joaobritooo/tobri-synth-rp2040/docs/img/overview.png

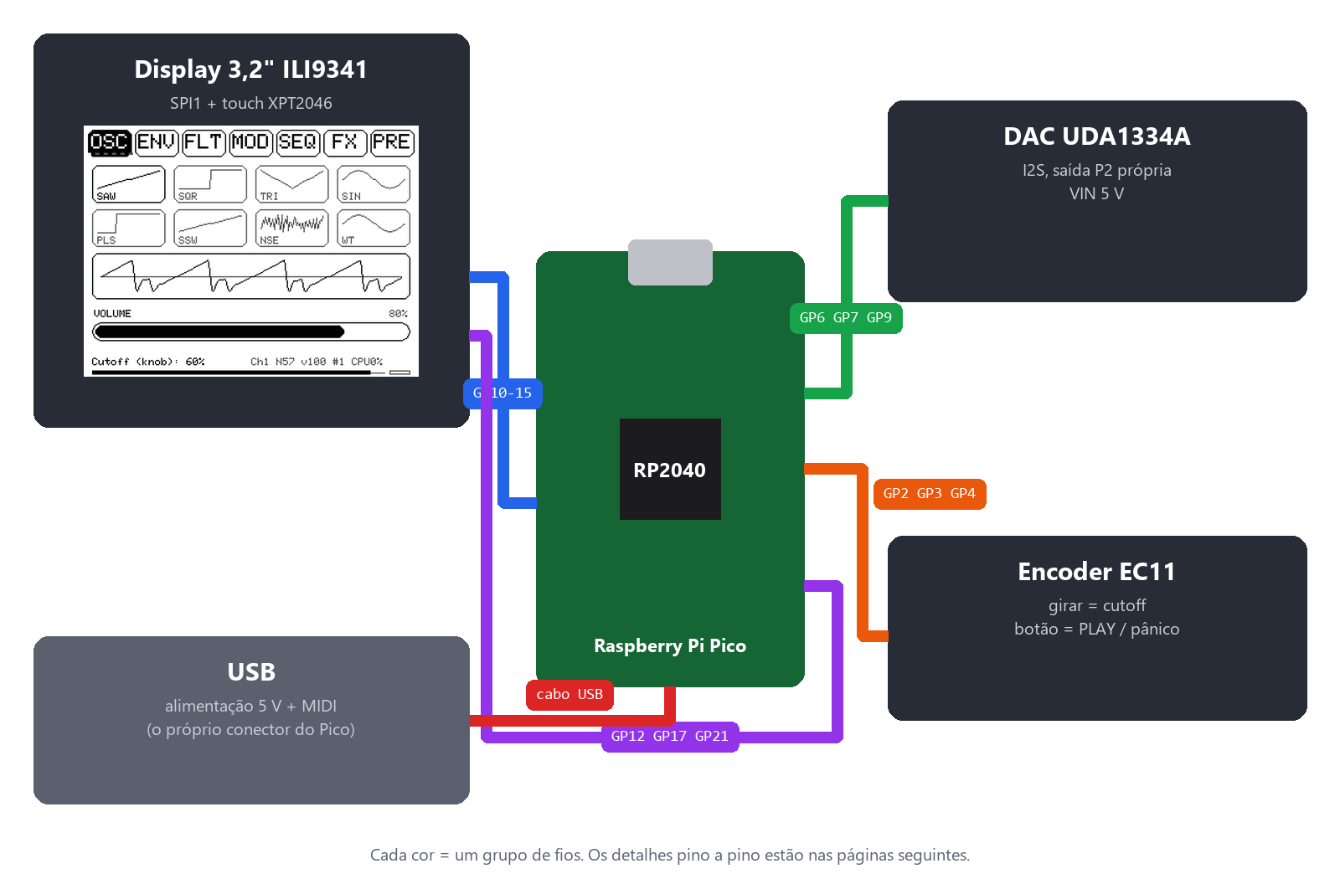
docs/img/overview.png
