joaobritooo/tobri-synth-rp2040/docs/img/screen_env.png

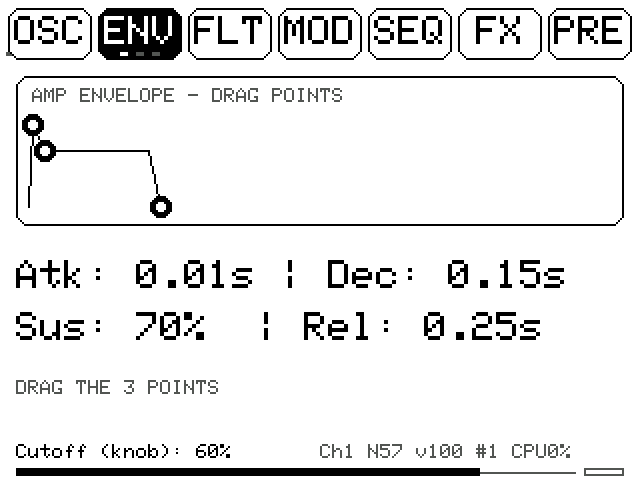
docs/img/screen_env.png
