joaobritooo/tobri-synth-rp2040/docs/img/screen_fx1.png

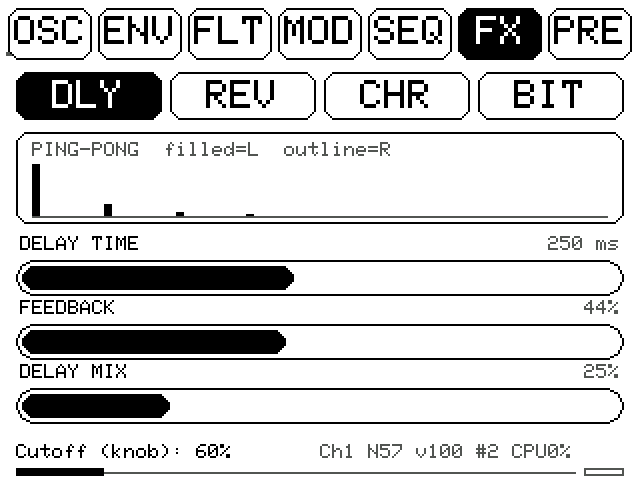
docs/img/screen_fx1.png
