joaobritooo/tobri-synth-rp2040/docs/img/screen_osc6.png

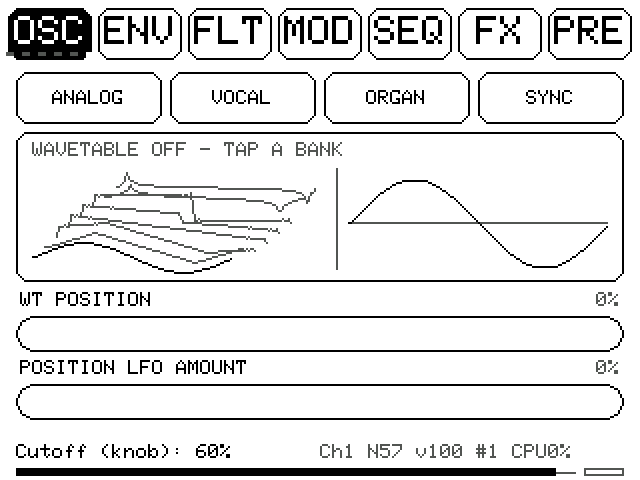
docs/img/screen_osc6.png
