joaobritooo/tobri-synth-rp2040/docs/img/screen_pre1.png

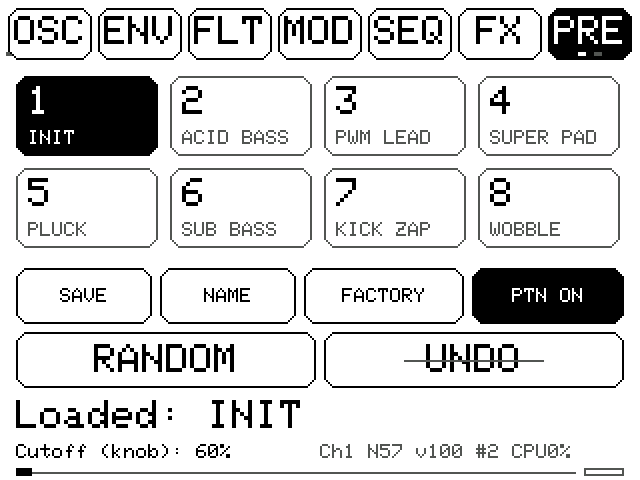
docs/img/screen_pre1.png
