joaobritooo/tobri-synth-rp2040/case/stl/tobri_panel.stl

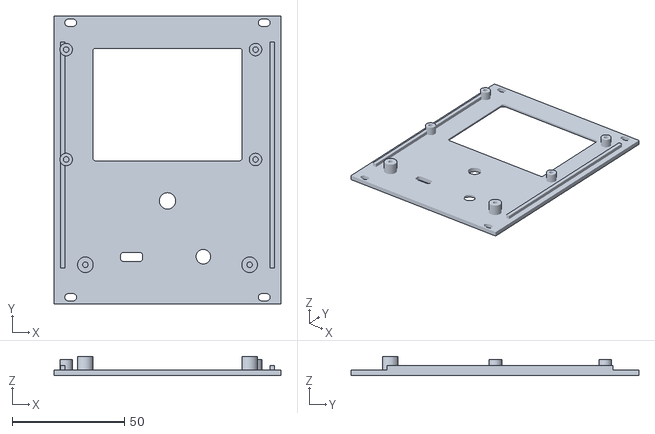
[picture p20: CAD file, 2026-10-31]
case/stl/tobri_panel.stl
101.3 x 128.5 x 8.50
