joaobritooo/tobri-synth-rp2040/case/stl/tobri_shelf.stl

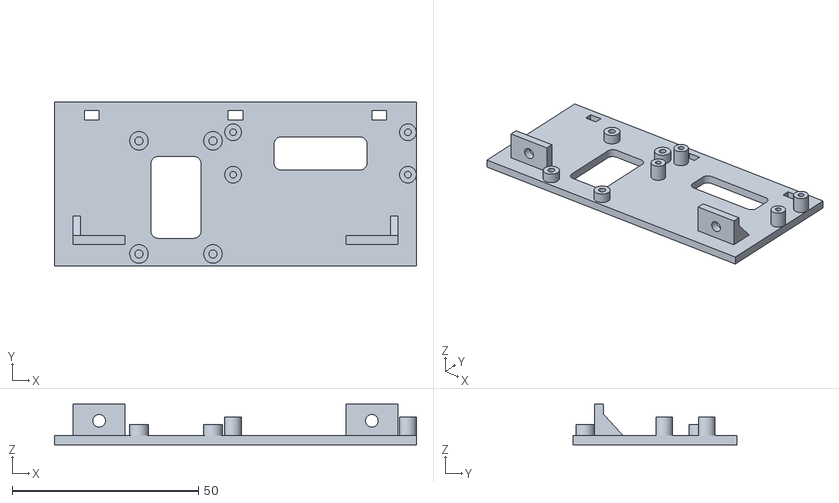
[picture p21: CAD file, 2026-10-31]
case/stl/tobri_shelf.stl
97.3 x 44.0 x 11.0
