joaobritooo/tobri-synth-rp2040/case/stl/tobri_knob.stl

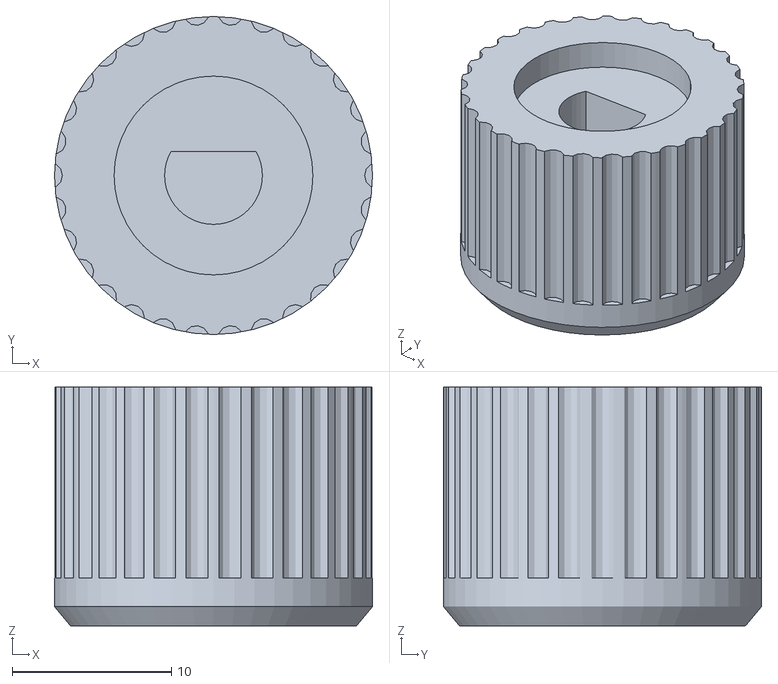
[picture p22: CAD file, 2026-10-31]
case/stl/tobri_knob.stl
20.0 x 20.0 x 15.0
