joaobritooo/tobri-synth-rp2040/(list of files, cad)

Other CAD files:
case/tobri_painel_knob.scad
