joaobritooo/tobri-synth-rp2040/firmware/tobri_synth_firmware_touchscreen_5/tobri_synth_firmware_touchscreen_5.ino

/* ============================================================================
   SINTETIZADOR RP2040 — USB MIDI DEVICE + TELA TOUCH (Tobri Synth)
   Abas: OSC / ENV / FLT / MOD / SEQ / FX / PRE
   (toque de novo na aba ativa para alternar entre as páginas)
   FX: DLY / REV / CHR / BIT   |   PRE página 2: MIDI MAP (learn dos knobs)
   NOVO: FLT p2 = filtro 12/24 dB | SEQ p3 = padrões A-D + chain |
         SEQ p1 = PROB e RATCH por passo | MOD p4 = matriz de modulação 4x4
   v5 (toque): leitura filtrada com máquina de estados (pollTouch), slider
         "preso" ao dedo durante o arraste, redesenho só quando o valor muda,
         FINE (afaste o dedo da barra na vertical), calibração do touch na EEPROM
         (PRE p2 > TOUCH CAL, ou segure o dedo na tela ao ligar)
   WAVETABLE: onda "WT" (OSC p1) + OSC p6 = 4 bancos x 8 quadros com morph;
         posição modulada pelo LFO e pela linha PWM/WT da matriz (MOD p4)
   v6: LFO com 5 formas + SYNC ao BPM (MOD p1) | accent 303 (SEQ p2) | ring mod
         (OSC p4) | wavefolder (FLT p2) | swipe troca subpágina | toque duplo no
         slider = valor padrão | UNDO depois de RND/CLR/COPY | medidor de saída
   v7: toque na aba ativa abre o MENU das subpáginas (com nomes). ENV agora tem
         AMP / FILTER ENV / PITCH ENV; FLT = FILTER (cutoff, reso, drive) + MODE
         (tipo, inclinação, wavefolder); MOD = LFO / MATRIX / VOICES
   v12: encoder com giro em GP4/GP3 e botão em GP2 (como está ligado na placa)
   v11: presets de fábrica minimal / deep tech (ROLLER, DUB CHORD, HYPNO PLCK, RUMBLE,
         BLIP, DEEP PAD, ACID TOOL, METAL PERC), cada um com groove próprio em Sol menor
   v10: botão do encoder ignora "apertos" que acontecem enquanto o eixo gira (ruído do
         SW); teste do encoder ao vivo em MOD > VOICE/GLIDE
   v9: abertura com as cores do menu + transição (varredura e abas caindo)
   v8: PRE p1 > RANDOM sorteia um som com "cara" (BASS, LEAD, PAD, PLUCK, KEYS) dentro de
         faixas musicais; UNDO volta ao som anterior (e REDO refaz) | tela de abertura
         com números caindo estilo Matrix
   ENCODER: girar = CUTOFF, segurar+girar = RESSONÂNCIA, clique = PLAY/STOP do
         SEQ, segurar parado = PÂNICO (lido por interrupção, com aceleração)
   Áudio 100% em inteiros (sem float por amostra); os floats são convertidos
   pelo core da tela em publishParams().
   ============================================================================ */

#ifndef USE_TINYUSB
#error "Arduino IDE: Ferramentas > USB Stack > selecione 'Adafruit TinyUSB' (o USB MIDI precisa dele)"
#endif
#include "Adafruit_TinyUSB.h"
#include <MIDI.h>
#include <I2S.h>
#include <SPI.h>
#include <EEPROM.h>
#include <Adafruit_GFX.h>
#include <Adafruit_ILI9341.h>
#include <XPT2046_Touchscreen.h>
#include <math.h>
#include <stdarg.h>

Adafruit_USBD_MIDI usb_midi;
MIDI_CREATE_INSTANCE(Adafruit_USBD_MIDI, usb_midi, MIDI);

// ---------------- PINOS ----------------
const int I2S_BCLK_PIN = 6;
const int I2S_DATA_PIN = 9;
I2S i2s(OUTPUT);

// encoder: giro em GP4 (CLK/A) e GP3 (DT/B), botão em GP2 (igual à montagem do protótipo)
const int ENC_CLK = 4, ENC_DT = 3, ENC_SW = 2;

const int TFT_SCK = 10, TFT_MOSI = 11, TFT_CS = 13, TFT_DC = 14, TFT_RST = 15;
Adafruit_ILI9341 tft = Adafruit_ILI9341(&SPI1, TFT_DC, TFT_CS, TFT_RST);

const int TOUCH_CS = 17, TOUCH_IRQ = 21, TOUCH_MISO = 12;
XPT2046_Touchscreen ts(TOUCH_CS, TOUCH_IRQ);

#define TS_MINX 315
#define TS_MAXX 3826
#define TS_MINY 310
#define TS_MAXY 3790

static bool core1_booting = true;

// ---------------- PALETA (Tema Limpo / Alto Contraste) ----------------
#define COL_BG      0xFFFF // Fundo Branco
#define COL_BORDER  0x0000 // Bordas e textos Pretos
#define COL_ACCENT  0x0000 // Elementos ativos Pretos
#define COL_ACCENT2 0x0000 // Linhas Pretas
#define COL_WARN    0x0000 // Avisos Pretos
#define COL_TEXT    0x0000 // Texto geral Preto
#define COL_MUTED   0x52AA // Cinza secundário
const int RADIUS = 6;

// ---------------- CANVAS (buffers anti-flicker) ----------------
const int PANEL_W = 304;
const int PANEL_H_MAX = 75;
GFXcanvas16 panelCanvas(PANEL_W, PANEL_H_MAX);
GFXcanvas16 sliderCanvas(PANEL_W, 30);

// ---------------- CONFIG DE AUDIO ----------------
const uint32_t SAMPLE_RATE   = 32000;
const int      MAX_VOICES     = 4;
const int      WAVETABLE_SIZE = 256;
const int32_t  ENV_ONE        = 1 << 24;     // envelopes em ponto fixo Q24
int16_t sineTable[WAVETABLE_SIZE];

enum Waveform  { WAVE_SAW = 0, WAVE_SQUARE, WAVE_TRIANGLE, WAVE_SINE, WAVE_PULSE, WAVE_SUPERSAW, WAVE_NOISE, WAVE_TABLE, WAVE_COUNT };
enum EnvStage  { ENV_IDLE = 0, ENV_ATTACK, ENV_DECAY, ENV_SUSTAIN, ENV_RELEASE };
enum Page      { PAGE_OSC = 0, PAGE_ENV = 1, PAGE_FLT = 2, PAGE_MOD = 3, PAGE_SEQ = 4, PAGE_FX = 5, PAGE_PRE = 6 };

struct Voice {
    bool    active = false;
    uint8_t note = 0;
    uint8_t velocity = 0;
    int32_t gainQ15 = 0;
    uint32_t phase = 0, phase2 = 0, phase3 = 0, phaseSub = 0;
    uint32_t phaseO2 = 0;              // OSC2: fase
    uint32_t uph[5] = {0, 0, 0, 0, 0}; // unison: fase de cada cópia
    uint32_t phaseFm = 0, pmOff = 0;   // FM: fase do modulador e desvio aplicado à portadora
    int32_t  fmEnv = 0, fmPrev = 0;    // FM: envelope do índice (Q24) e última saída do modulador (feedback)
    uint32_t phaseInc = 0;
    uint32_t incEff = 0;
    uint32_t inc2 = 0, inc3 = 0;
    uint32_t targetInc = 0;
    int32_t env = 0;
    EnvStage stage = ENV_IDLE;
    int32_t filtEnv = 0;
    EnvStage filtStage = ENV_IDLE;
    int32_t pitchEnv = 0;
    uint32_t age = 0;
};
Voice voices[MAX_VOICES];
uint32_t voiceCounter = 0;

Waveform currentWave  = WAVE_SAW;
float paramAttack  = 0.01f, paramDecay = 0.15f, paramSustain = 0.70f, paramRelease = 0.25f;
float paramCutoff  = 0.60f, paramReso = 0.20f, paramVolume = 0.80f;

float paramFiltAtt   = 0.01f;
float paramFiltDec   = 0.20f;
float paramFiltAmt   = 0.50f;

float paramLfoRate  = 2.0f;
float paramLfoDepth = 0.0f;
float paramDetune   = 0.50f;

float paramPwm        = 0.30f;
float paramPwmMod     = 0.00f;
float paramSubLevel   = 0.00f;
float paramPitchAmt   = 0.00f;
float paramPitchDecMs = 80.0f;
float paramVelFilt    = 0.00f;
float paramSwing      = 0.00f;
float paramDrive      = 0.00f;
float paramGlideMs    = 60.0f;

// FM (modulação de fase por 1 operador modulador, seno)
float paramFmAmt     = 0.00f;    // quantidade (índice máx. ~12,6 rad, curva quadrática)
float paramFmRatio   = 2.00f;    // razão modulador/portadora
float paramFmDecMs   = 200.0f;   // decaimento do envelope do índice
float paramFmEnv     = 0.50f;    // quanto o índice segue o envelope (0 = constante)
float paramFmFb      = 0.00f;    // feedback do modulador (deixa o timbre mais "serrilhado")
static volatile bool fmSnap = true;   // razão em passos de 0,5

// OSC2 (segundo oscilador, com hard sync) e UNISON
float paramO2Lvl  = 0.00f;     // nível (0 = desligado)
float paramO2Semi = 0.0f;      // -24..+24 semitons
float paramO2Det  = 0.0f;      // -100..+100 cents
float paramUniDet = 0.40f;     // abertura do unison
static volatile uint8_t o2Wave = 0;     // 0 saw, 1 quadrada, 2 triangular, 3 senoide
static volatile bool    o2Sync = false;
static volatile uint8_t uniSel = 0;     // 0 = off, 1 = 2 cópias, 2 = 3 cópias, 3 = 5 cópias
static volatile uint8_t subMode = 0;        // 0 = quadrada, 1 = senoide
static volatile uint8_t filtMode = 0;       // 0 = LP, 1 = BP, 2 = HP
static volatile uint8_t filtSlope = 0;      // 0 = 12 dB/oit, 1 = 24 dB/oit (2 SVF em cascata)
static volatile uint8_t voiceMode = 0;      // 0 = POLY, 1 = MONO, 2 = LEGATO
static volatile bool    monoResetReq = false;
static volatile uint8_t lastVelocity = 100;
static volatile uint8_t cpuPct = 0;

// Efeitos
float paramDelayTime = 250.0f;
float paramDelayFb   = 0.40f;
float paramDelayMix  = 0.25f;
float paramRevSize   = 0.60f;
float paramRevDamp   = 0.40f;
float paramRevMix    = 0.20f;
float paramChoRate   = 0.80f;
float paramChoDepth  = 0.50f;
float paramChoMix    = 0.00f;
float paramCrBits    = 16.0f;
float paramCrRate    = 1.0f;
float paramCrMix     = 0.00f;

// LFO: forma e sincronia com o BPM | accent 303 | ring mod | wavefolder
static volatile uint8_t lfoShape = 0;      // 0 seno, 1 triângulo, 2 dente de serra, 3 quadrada, 4 sample & hold
static volatile bool    lfoSync  = false;  // true: o LFO RATE vira divisão do BPM do sequenciador
float paramAccent = 0.40f;                 // accent 303: quanto cada passo com accent abre o filtro (acumula)
static volatile bool    o2Ring = false;    // OSC2 vira ring mod (OSC1 x OSC2)
float paramFold   = 0.00f;                 // wavefolder antes do filtro
static volatile int32_t pAccentQ15 = 13107, pFoldGainQ8 = 256;
static volatile bool    pFoldOn = false;
static volatile int32_t outPeak = 0;       // pico da saída (medidor na barra de baixo)
static volatile bool    outClip = false;

// divisões do LFO sincronizado (em notas inteiras: 1 = um compasso 4/4)
const float LFO_SYNC_WHOLE[9] = {2.0f, 1.0f, 0.5f, 0.25f, 1.0f / 6.0f, 0.125f, 1.0f / 12.0f, 0.0625f, 0.03125f};
const char* LFO_SYNC_NAMES[9] = {"2 BARS", "1 BAR", "1/2", "1/4", "1/4T", "1/8", "1/8T", "1/16", "1/32"};

// Estado do filtro (ponto fixo Q8) e do LFO (fase de 32 bits)
static int32_t  svL = 0, svB = 0;
static int32_t  sv2L = 0, sv2B = 0;            // 2º estágio do filtro (modo 24 dB)
static int32_t  volTargetQ15 = 26214, volCurQ15 = 26214;
static uint32_t pitchModMul = 65536;           // multiplicador de pitch da matriz (Q16)
static uint32_t pitchModTbl[129];              // 2^((i-64)/64) em Q16 (±1 oitava)

// Matriz de modulação: índice = destino*4 + fonte
// fontes: 0 LFO, 1 FILT ENV, 2 AMP ENV, 3 VELOCITY | destinos: 0 CUTOFF, 1 PITCH, 2 PWM, 3 VOLUME
float mmAmt[16] = {0};
static volatile int32_t pMmQ15[16];
static volatile bool    pMmOn = false, pPitchModOn = false;
static uint32_t lfoPhase32 = 0;
static int32_t  lfoHold = 0;                   // valor segurado do LFO sample & hold
static int32_t  accentEnvQ15 = 0;              // carga do accent 303 (core de áudio)
int16_t lastPlayedSample = 0;

// ---- Parâmetros PUBLICADOS em ponto fixo ----
// O core da tela (publishParams) converte os floats; o core de áudio só lê inteiros.
static volatile int32_t  pCutBaseQ15 = 19661, pLfoHalfQ15 = 0, pFiltAmtQ15 = 16384, pVelFiltQ15 = 0;
static volatile int32_t  pQTargetQ14 = 12000;
static volatile uint32_t pLfoInc32 = 268435;
static volatile int32_t  pPwmBaseQ16 = 19661, pPwmModQ16 = 0;
static volatile bool     pDriveOn = false;
static volatile int32_t  pDriveGainQ8 = 256, pDriveCompQ15 = 32768;
static volatile int32_t  pSelfWetQ15 = 0;
static volatile bool     pSeedOn = false;
static volatile int32_t  pSpreadQ16 = 0;
static volatile int32_t  pMainGainQ15 = 32768, pSubGainQ15 = 0;
static volatile int32_t  pSwingQ8 = 0;
static volatile int      pGlideShift = 11;
static volatile int32_t  pPitchDecInc = 1;
static volatile bool     pPitchOn = false;
static volatile bool     pFmOn = false;
static volatile bool     pO2On = false, pO2Sync = false;
static volatile int32_t  pO2MulQ8 = 256, pO2MainQ15 = 32768, pO2GainQ15 = 0;
static volatile int      pUniN = 1;
static volatile int32_t  pUniGainQ15 = 32768;
static volatile int32_t  pUniSpreadQ16[5] = {0, 0, 0, 0, 0};
static volatile int32_t  pFmIdxQ12 = 0, pFmRatioQ8 = 512, pFmEnvQ15 = 16384, pFmFbQ12 = 0, pFmDecInc = 1;

// Osciloscópio
const int SCOPE_LEN = 512;
static int16_t scopeBuf[SCOPE_LEN];
static volatile uint16_t scopeW = 0;

// ---------------- WIDGETS / ESTRUTURAS ----------------
// fmt: 0 = %, 1 = Hz, 2 = ms, 3 = semitons, 4 = segundos em ms, 5 = bits, 6 = divisor 1/n
struct TouchSlider { int x, y, w, h; float *value; float minV, maxV; const char *label; uint8_t fmt; float last; float def; };   // def: preenchido no boot
struct Btn         { int x, y, w, h; const char *label; };
// probIdx: 0=100% 1=75% 2=50% 3=25%  |  ratchIdx: 0..3 = 1x..4x (zero = padrão)
struct SeqStep     { uint8_t semi; int8_t oct; bool gate; bool accent; bool slide; uint8_t probIdx; uint8_t ratchIdx; };
struct AdsrPts     { int xa, xd, xs, xr, yTop, ySus, yBot; };

// Preset gravado na flash (160 bytes)
struct PresetData {
    uint8_t  magic, wave, hasPattern, reserved;
    uint16_t bpm, crc;
    float attack, decay, sustain, release;
    float cutoff, reso, filtAmt, filtAtt, filtDec;
    float lfoRate, lfoDepth, detune, volume;
    float dlyTime, dlyFb, dlyMix, revSize, revDamp, revMix;
    float pwm, pwmMod, subLevel, pitchAmt, pitchDec, velFilt, swing;
    uint8_t semi[16];
    int8_t  oct[16];
    uint8_t flags[16];
};

// cópia do som para o UNDO/REDO do RANDOM (PRE p1)
struct SoundSnap { float f[48]; uint8_t b[12]; float mm[16]; uint8_t wave; };
uint8_t rndUndoState = 0;            // 0 = nada para desfazer, 1 = UNDO disponível, 2 = REDO disponível

// Preset de fábrica
struct FactoryPreset {
    const char *name; uint8_t wave;
    float a, d, s, r;
    float cut, res, fAmt, fAtt, fDec;
    float lfoR, lfoD, det, vol;
    float dT, dF, dM;
    float rS, rD, rM;
    float pwm, pwmMod, sub, pAmt, pDecMs, vel;
    float drive; uint8_t fmode; uint8_t vmode; float glide;
};

const int PRESET_COUNT = 8;
volatile int presetReq = -1;
bool presetLoadPattern = true;
int  presetCur = 0;
bool slotIsUser[PRESET_COUNT] = {false, false, false, false, false, false, false, false};
char presetMsg[40] = "Tap a slot to load";

// Aba OSC
TouchSlider sliderVolume   = {8, 176, 304, 30, &paramVolume,   0.0f, 1.0f,  "VOLUME",      0, -999.0f};
TouchSlider sliderPwm      = {8, 118, 304, 30, &paramPwm,      0.05f, 0.95f, "PULSE WIDTH", 0, -999.0f};
TouchSlider sliderPwmMod   = {8, 150, 304, 30, &paramPwmMod,   0.0f, 1.0f,  "PWM LFO AMOUNT", 0, -999.0f};
TouchSlider sliderSubLvl   = {8, 182, 304, 30, &paramSubLevel, 0.0f, 1.0f,  "SUB LEVEL",   0, -999.0f};
// Aba FLT
TouchSlider sliderCutoff   = {8, 118, 304, 30, &paramCutoff,   0.05f, 1.0f, "CUTOFF FREQ", 0, -999.0f};
TouchSlider sliderReso     = {8, 150, 304, 30, &paramReso,     0.0f, 1.0f,  "RESSONANCIA", 0, -999.0f};
TouchSlider sliderFiltAmt  = {8, 96,  304, 30, &paramFiltAmt,  0.0f, 1.0f,  "FILTER ENV AMOUNT", 0, -999.0f};
TouchSlider sliderDrive    = {8, 182, 304, 30, &paramDrive,    0.0f, 1.0f,  "DRIVE",       0, -999.0f};
TouchSlider sliderFAtt     = {8, 128, 304, 30, &paramFiltAtt,  0.001f, 1.0f, "FILTER ENV ATTACK", 4, -999.0f};
TouchSlider sliderFDec     = {8, 160, 304, 30, &paramFiltDec,  0.01f, 2.0f, "FILTER ENV DECAY",  4, -999.0f};
TouchSlider sliderFold     = {8, 100, 304, 30, &paramFold,     0.0f, 1.0f,  "WAVEFOLDER",  0, -999.0f};
// Aba MOD
TouchSlider sliderLfoRate  = {8, 118, 304, 30, &paramLfoRate,  0.1f, 20.0f, "LFO RATE",    1, -999.0f};
TouchSlider sliderLfoDepth = {8, 150, 304, 30, &paramLfoDepth, 0.0f, 1.0f,  "LFO DEPTH",   0, -999.0f};
TouchSlider sliderDetune   = {8, 182, 304, 30, &paramDetune,   0.0f, 1.0f,  "DETUNE",      0, -999.0f};
TouchSlider sliderPitchAmt = {8, 118, 304, 30, &paramPitchAmt, 0.0f, 1.0f,  "PITCH ENV AMOUNT", 3, -999.0f};
TouchSlider sliderPitchDec = {8, 150, 304, 30, &paramPitchDecMs, 5.0f, 800.0f, "PITCH ENV DECAY", 2, -999.0f};
TouchSlider sliderVelFilt  = {8, 192, 304, 28, &paramVelFilt,  0.0f, 1.0f,  "VELOCITY > FILTER", 0, -999.0f};
TouchSlider sliderGlide    = {8, 72,  304, 30, &paramGlideMs,  1.0f, 500.0f, "GLIDE TIME",  2, -999.0f};
// Aba MOD página 4 (matriz): o ponteiro/label mudam conforme a célula selecionada
char mmLabel[24] = "LFO > CUTOFF";
TouchSlider sliderMm       = {8, 162, 304, 30, &mmAmt[0], -1.0f, 1.0f, mmLabel, 7, -999.0f};
// Aba OSC página 3 (FM)
TouchSlider sliderFmAmt    = {8, 62,  304, 30, &paramFmAmt,    0.0f, 1.0f,    "FM AMOUNT",      0, -999.0f};
TouchSlider sliderFmRatio  = {8, 94,  304, 30, &paramFmRatio,  0.5f, 12.0f,   "FM RATIO",       8, -999.0f};
TouchSlider sliderFmDec    = {8, 126, 304, 30, &paramFmDecMs,  5.0f, 2000.0f, "FM DECAY",       2, -999.0f};
TouchSlider sliderFmEnv    = {8, 158, 304, 30, &paramFmEnv,    0.0f, 1.0f,    "FM ENV FOLLOW",  0, -999.0f};
TouchSlider sliderFmFb     = {8, 190, 304, 30, &paramFmFb,     0.0f, 1.0f,    "FM FEEDBACK",    0, -999.0f};
// Aba OSC páginas 4 (OSC2) e 5 (UNISON)
TouchSlider sliderO2Lvl    = {8, 92,  304, 30, &paramO2Lvl,    0.0f, 1.0f,    "OSC2 LEVEL (0 = OFF)", 0, -999.0f};
TouchSlider sliderO2Semi   = {8, 124, 304, 30, &paramO2Semi,   -24.0f, 24.0f, "OSC2 SEMITONES",        9, -999.0f};
TouchSlider sliderO2Det    = {8, 156, 304, 30, &paramO2Det,    -100.0f, 100.0f, "OSC2 FINE TUNE",      10, -999.0f};
TouchSlider sliderUniDet   = {8, 70,  304, 30, &paramUniDet,   0.0f, 1.0f,    "UNISON SPREAD",         0, -999.0f};
// Aba SEQ
TouchSlider sliderSwing    = {8, 70,  304, 30, &paramSwing,    0.0f, 1.0f,  "SWING",       0, -999.0f};
TouchSlider sliderAccent   = {8, 170, 304, 30, &paramAccent,   0.0f, 1.0f,  "ACCENT SWEEP (303)", 0, -999.0f};
// Aba FX
TouchSlider sliderDlyTime  = {8, 118, 304, 30, &paramDelayTime, 40.0f, 500.0f, "DELAY TIME", 2, -999.0f};
TouchSlider sliderDlyFb    = {8, 150, 304, 30, &paramDelayFb,   0.0f, 0.90f,   "FEEDBACK",   0, -999.0f};
TouchSlider sliderDlyMix   = {8, 182, 304, 30, &paramDelayMix,  0.0f, 1.0f,    "DELAY MIX",  0, -999.0f};
TouchSlider sliderRevSize  = {8, 118, 304, 30, &paramRevSize,   0.0f, 1.0f,    "ROOM SIZE",  0, -999.0f};
TouchSlider sliderRevDamp  = {8, 150, 304, 30, &paramRevDamp,   0.0f, 1.0f,    "DAMPING",    0, -999.0f};
TouchSlider sliderRevMix   = {8, 182, 304, 30, &paramRevMix,    0.0f, 1.0f,    "REVERB MIX", 0, -999.0f};
TouchSlider sliderChoRate  = {8, 118, 304, 30, &paramChoRate,   0.1f, 5.0f,    "CHORUS RATE", 1, -999.0f};
TouchSlider sliderChoDepth = {8, 150, 304, 30, &paramChoDepth,  0.0f, 1.0f,    "CHORUS DEPTH", 0, -999.0f};
TouchSlider sliderChoMix   = {8, 182, 304, 30, &paramChoMix,    0.0f, 1.0f,    "CHORUS MIX", 0, -999.0f};
TouchSlider sliderCrBits   = {8, 118, 304, 30, &paramCrBits,    4.0f, 16.0f,   "BIT DEPTH", 5, -999.0f};
TouchSlider sliderCrRate   = {8, 150, 304, 30, &paramCrRate,    1.0f, 24.0f,   "SAMPLE RATE DIVIDER", 6, -999.0f};
TouchSlider sliderCrMix    = {8, 182, 304, 30, &paramCrMix,     0.0f, 1.0f,    "CRUSH MIX",  0, -999.0f};

// índice da divisão do LFO sincronizado (fica depois das structs: o Arduino põe os
// protótipos antes da primeira função do arquivo)
int lfoSyncIdx() { return constrain((int)((paramLfoRate - 0.1f) / 19.9f * 8.0f + 0.5f), 0, 8); }

const uint8_t SYNTH_KEY_LOW  = 24;
const uint8_t SYNTH_KEY_HIGH = 108;
const uint8_t CC_KNOB[8] = {48, 49, 50, 51, 52, 53, 54, 55};
int knobValue[8] = {90, 25, 15, 60, 90, 60, 0, 100};

char lastMidiMsg[40] = "aguardando midi...";
static volatile uint32_t midiRxCount = 0;

// ============================================================================
// OSCILADOR / ENVELOPE / AUDIO  (tudo em inteiros)
// ============================================================================
float noteToFreq(uint8_t note) { return 440.0f * powf(2.0f, (note - 69) / 12.0f); }
uint32_t freqToPhaseInc(float freq) { return (uint32_t)(freq * (4294967296.0 / (double)SAMPLE_RATE)); }

static uint32_t noteIncTable[128];
static uint32_t pitchMulTbl[2][129];            // 2^(oitavas * i/128) em Q16 (duas tabelas, troca atômica)
static volatile uint8_t pitchTblSel = 0;
static uint16_t fTableQ14[1025];                // coeficiente f do filtro (Q14) por posição do cutoff

void initNoteTable() {
    for (int i = 0; i < 128; i++) noteIncTable[i] = freqToPhaseInc(noteToFreq((uint8_t)i));
    for (int t = 0; t < 2; t++) for (int i = 0; i < 129; i++) pitchMulTbl[t][i] = 65536u;
}

// f = 2*sin(pi*fc/fs), fc = 120 + m^2 * 8000 (limitado a 0,45*fs), f <= 1,15
void initFilterTable() {
    for (int i = 0; i <= 1024; i++) {
        float m = (float)i / 1024.0f;
        float fc = 120.0f + m * m * 8000.0f;
        if (fc > (float)SAMPLE_RATE * 0.45f) fc = (float)SAMPLE_RATE * 0.45f;
        float f = 2.0f * sinf((float)M_PI * fc / (float)SAMPLE_RATE);
        if (f > 1.15f) f = 1.15f;
        fTableQ14[i] = (uint16_t)(f * 16384.0f + 0.5f);
    }
}

void initPitchModTable() {
    for (int i = 0; i < 129; i++) pitchModTbl[i] = (uint32_t)(exp2f((float)(i - 64) / 64.0f) * 65536.0f);
}

static uint32_t rngState = 0x1234ABCDu;
static uint32_t pulseWQ32 = 1288490188u;

// ---------------- PolyBLEP em ponto fixo (anti-aliasing) ----------------
static inline __attribute__((always_inline)) int16_t sat16(int32_t v) {
    if (v > 32767)  return 32767;
    if (v < -32768) return -32768;
    return (int16_t)v;
}

static inline __attribute__((always_inline)) uint32_t ratioQ15(uint32_t a, uint32_t b) {
    int s = __builtin_clz(b);
    uint32_t bb = b << s;
    uint32_t aa = a << s;
    return ((aa >> 16) << 15) / (bb >> 16);
}

static int32_t __not_in_flash_func(blepQ15)(uint32_t ph, uint32_t inc) {
    if (inc == 0) return 0;
    if (ph < inc) {
        int32_t x = (int32_t)ratioQ15(ph, inc);
        return 2 * x - ((x * x) >> 15) - 32768;
    }
    uint32_t d = 0u - ph;
    if (d < inc) {
        int32_t y = (int32_t)ratioQ15(d, inc);
        int32_t u = 32768 - y;
        return (u * u) >> 15;
    }
    return 0;
}

// seno com interpolação linear (usado pelo modulador FM e pela onda senoidal)
static inline __attribute__((always_inline)) int32_t sineInterp(uint32_t ph) {
    uint32_t i = ph >> 24;
    int32_t a = sineTable[i], b = sineTable[(i + 1) & 255];
    return a + (((b - a) * (int32_t)((ph >> 16) & 255)) >> 8);
}

// ---------------- WAVETABLE (4 bancos x 8 quadros, morph entre quadros) ----------------
// Quadros gerados por síntese aditiva no boot (wtInit), todos com fase seno: assim o
// crossfade entre quadros vizinhos não cancela harmônicos. Dois níveis de mipmap:
// até 40 harmônicos (sem aliasing até ~400 Hz) e até 10 (para notas mais agudas).
const int      WT_BANKS = 4, WT_FRAMES = 8, WT_LEN = 256;
const int      WT_HARM[2] = {40, 10};
const uint32_t WT_MIP_INC = 53687091u;          // incremento de fase de 400 Hz
const char*    WT_BANK_NAMES[WT_BANKS] = {"ANALOG", "VOCAL", "ORGAN", "SYNC"};
static int16_t wtData[2][WT_BANKS][WT_FRAMES][WT_LEN];   // 32 KB na RAM
static volatile uint8_t wtBank = 0;
float paramWtPos = 0.0f;         // posição base na tabela (0..1)
float paramWtLfo = 0.0f;         // quanto o LFO varre a posição
static volatile int32_t pWtPosQ16 = 0, pWtLfoQ15 = 0;
static int32_t wtPosTarget = 0, wtPosCur = 0;   // Q16: alvo (tick de controle) e suavizado (por amostra)
static int     wtFrame = 0;                     // quadro inferior da interpolação (0..6)
static int32_t wtFracQ14 = 0;

// amplitude do harmônico h (1..40) no quadro f de cada banco
static float wtHarmAmp(int bank, int f, int h) {
    const bool odd = (h & 1) != 0;
    const float saw = 1.0f / h;
    const float sqr = odd ? saw : 0.0f;
    const float tri = odd ? (((h >> 1) & 1) ? -1.0f : 1.0f) / (float)(h * h) : 0.0f;
    switch (bank) {
        case 0: {                    // ANALOG: seno > tri > saw > quadrada > pulsos estreitos
            switch (f) {
                case 0:  return (h == 1) ? 1.0f : 0.0f;
                case 1:  return tri;
                case 2:  return 0.5f * tri + 0.5f * saw;
                case 3:  return saw;
                case 4:  return 0.5f * saw + 0.5f * sqr;
                case 5:  return sqr;
                case 6:  return sinf((float)M_PI * h * 0.25f) * saw;
                default: return sinf((float)M_PI * h * 0.10f) * saw;
            }
        }
        case 1: {                    // VOCAL: dois formantes que sobem com o quadro
            float c1 = 1.5f * powf(1.45f, (float)f), c2 = c1 * 2.7f;
            float g1 = (h - c1) / (0.25f * c1 + 1.0f), g2 = (h - c2) / (0.25f * c2 + 1.0f);
            return saw * (0.15f + 3.0f * expf(-g1 * g1) + 1.5f * expf(-g2 * g2));
        }
        case 2: {                    // ORGAN: registros de drawbar (harmônicos 1,2,3,4,5,6,8)
            static const float REG[8][7] = {
                {1, 0, 0, 0, 0, 0, 0},       {1, .8f, 0, 0, 0, 0, 0},
                {1, .8f, .6f, 0, 0, 0, 0},   {1, .8f, .6f, .8f, 0, 0, 0},
                {1, .6f, .8f, .6f, .5f, 0, 0}, {1, .8f, .8f, .8f, .6f, .6f, 0},
                {1, 1, 1, 1, .8f, .8f, .8f}, {.6f, .4f, 1, .3f, 1, .3f, 1}};
            static const int8_t SLOT[9] = {-1, 0, 1, 2, 3, 4, 5, -1, 6};
            return (h <= 8 && SLOT[h] >= 0) ? REG[f][SLOT[h]] * 0.5f : 0.0f;
        }
        default: {                   // SYNC: saw com ressonância no último harmônico (som de hard sync)
            static const int N[8] = {1, 2, 3, 5, 8, 13, 21, 40};
            if (h > N[f]) return 0.0f;
            return (h == N[f] && f > 0) ? saw * 2.5f : saw;
        }
    }
}

void wtInit() {
    int32_t amp[41];
    int32_t acc[WT_LEN];
    for (int m = 0; m < 2; m++) {
        for (int b = 0; b < WT_BANKS; b++) {
            for (int f = 0; f < WT_FRAMES; f++) {
                // amplitudes escaladas para o maior harmônico = 32767 (evita estouro na soma)
                float fa[41], amax = 1e-6f;
                for (int h = 1; h <= WT_HARM[m]; h++) { fa[h] = wtHarmAmp(b, f, h); if (fabsf(fa[h]) > amax) amax = fabsf(fa[h]); }
                for (int h = 1; h <= WT_HARM[m]; h++) amp[h] = (int32_t)(fa[h] / amax * 32767.0f);
                int32_t peak = 1;
                for (int i = 0; i < WT_LEN; i++) {
                    int32_t s = 0;
                    for (int h = 1; h <= WT_HARM[m]; h++) {
                        if (amp[h]) s += (amp[h] * sineTable[(i * h) & 255]) >> 8;
                    }
                    acc[i] = s;
                    int32_t a = (s < 0) ? -s : s;
                    if (a > peak) peak = a;
                }
                for (int i = 0; i < WT_LEN; i++)   // normaliza cada quadro para pico ~30000
                    wtData[m][b][f][i] = (int16_t)(((int64_t)acc[i] * 30000) / peak);
            }
        }
    }
}

static inline __attribute__((always_inline)) int32_t wtLerp(const int16_t *t, uint32_t ph) {
    uint32_t i = ph >> 24;
    int32_t a = t[i], b = t[(i + 1) & 255];
    return a + (((b - a) * (int32_t)((ph >> 16) & 255)) >> 8);
}

// uma cópia do oscilador principal (usada pelo unison e pelo oscSample)
static int16_t __not_in_flash_func(oscSampleAt)(uint32_t ph, uint32_t inc) {
    switch (currentWave) {
        case WAVE_TABLE: {
            const int16_t *f0 = wtData[(inc > WT_MIP_INC) ? 1 : 0][wtBank & 3][wtFrame];
            int32_t a = wtLerp(f0, ph);
            int32_t b = wtLerp(f0 + WT_LEN, ph);          // quadro seguinte (wtFrame <= 6)
            return (int16_t)(a + (((b - a) * wtFracQ14) >> 14));
        }
        case WAVE_SAW: {
            int32_t s = (int32_t)(ph >> 16) - 32768;
            return sat16(s - blepQ15(ph, inc));
        }
        case WAVE_SQUARE: {
            int32_t s = (ph & 0x80000000UL) ? 32767 : -32768;
            s += blepQ15((uint32_t)(ph + 0x80000000u), inc) - blepQ15(ph, inc);
            return sat16(s);
        }
        case WAVE_PULSE: {
            int32_t s = (ph < pulseWQ32) ? 32767 : -32768;
            s += blepQ15(ph, inc) - blepQ15((uint32_t)(ph - pulseWQ32), inc);
            return sat16(s);
        }
        case WAVE_TRIANGLE: {
            int32_t saw = (int32_t)(ph >> 16) - 32768;
            int32_t a = (saw < 0) ? -saw : saw;
            int32_t t = a * 2 - 32768;
            if (t > 32767) t = 32767;
            return (int16_t)t;
        }
        case WAVE_NOISE: {
            rngState ^= rngState << 13;
            rngState ^= rngState >> 17;
            rngState ^= rngState << 5;
            return (int16_t)(rngState >> 16);
        }
        case WAVE_SINE:
        default: return (int16_t)sineInterp(ph);
    }
}

static int16_t __not_in_flash_func(oscSample)(Voice &v) {
    const uint32_t inc = v.incEff;
    const uint32_t pm  = v.pmOff;          // desvio de fase do modulador FM (0 = FM desligado)
    if (currentWave == WAVE_SUPERSAW) {
        const uint32_t ph = v.phase + pm;
        int32_t s1 = (int32_t)(ph >> 16) - 32768 - blepQ15(ph, inc);
        int32_t s2 = (int32_t)((v.phase2 + pm) >> 16) - 32768 - blepQ15((v.phase2 + pm), v.inc2);
        int32_t s3 = (int32_t)((v.phase3 + pm) >> 16) - 32768 - blepQ15((v.phase3 + pm), v.inc3);
        return sat16((s1 + s2 + s3) / 3);
    }
    return oscSampleAt(v.phase + pm, inc);
}

// OSC2: 0 = saw, 1 = quadrada, 2 = triangular, 3 = senoide
static int32_t __not_in_flash_func(osc2Sample)(uint32_t ph, uint32_t inc, uint8_t w) {
    switch (w) {
        case 0: {
            int32_t s = (int32_t)(ph >> 16) - 32768;
            return sat16(s - blepQ15(ph, inc));
        }
        case 1: {
            int32_t s = (ph & 0x80000000UL) ? 32767 : -32768;
            s += blepQ15((uint32_t)(ph + 0x80000000u), inc) - blepQ15(ph, inc);
            return sat16(s);
        }
        case 2: {
            int32_t saw = (int32_t)(ph >> 16) - 32768;
            int32_t a = (saw < 0) ? -saw : saw;
            int32_t t = a * 2 - 32768;
            return (t > 32767) ? 32767 : t;
        }
        default: return sineInterp(ph);
    }
}

static int32_t __not_in_flash_func(subSample)(uint32_t ph, uint32_t inc) {
    if (subMode) return sineTable[ph >> 24];
    int32_t s = (ph & 0x80000000UL) ? 32767 : -32768;
    s += blepQ15((uint32_t)(ph + 0x80000000u), inc) - blepQ15(ph, inc);
    return s;
}

// Incrementos dos envelopes (Q24 por amostra) — escritos pelo core da tela
static volatile int32_t envAttInc = 1, envDecInc = 1, envRelInc = 1, envFAttInc = 1, envFDecInc = 1;
static volatile int32_t envSusQ = 0;
static volatile int32_t volQ15 = 0;

static int32_t envIncFor(float seconds) {
    float s = (seconds < 0.001f) ? 0.001f : seconds;
    int32_t inc = (int32_t)((float)ENV_ONE / (s * (float)SAMPLE_RATE));
    return (inc < 1) ? 1 : inc;
}

void updateEnvCoefs() {
    envAttInc  = envIncFor(paramAttack);
    envDecInc  = envIncFor(paramDecay);
    envRelInc  = envIncFor(paramRelease);
    envFAttInc = envIncFor(paramFiltAtt);
    envFDecInc = envIncFor(paramFiltDec);
    float sus = (paramSustain < 0.0f) ? 0.0f : ((paramSustain > 1.0f) ? 1.0f : paramSustain);
    envSusQ = (int32_t)(sus * (float)ENV_ONE);
    float vol = (paramVolume < 0.0f) ? 0.0f : ((paramVolume > 1.0f) ? 1.0f : paramVolume);
    volQ15 = (int32_t)(vol * 32768.0f);
}

// Envelope de amplitude: 1 passo por amostra
static inline __attribute__((always_inline)) void ampEnvStep(Voice &v) {
    switch (v.stage) {
        case ENV_ATTACK:  v.env += envAttInc; if (v.env >= ENV_ONE) { v.env = ENV_ONE; v.stage = ENV_DECAY; } break;
        case ENV_DECAY:   v.env -= envDecInc; if (v.env <= envSusQ) { v.env = envSusQ; v.stage = ENV_SUSTAIN; } break;
        case ENV_SUSTAIN: v.env = envSusQ; break;
        case ENV_RELEASE: v.env -= envRelInc; if (v.env <= 0) { v.env = 0; v.stage = ENV_IDLE; v.active = false; } break;
        default: break;
    }
}

// Envelope do filtro: 32 passos de uma vez, uma vez por tick de controle (1 kHz)
static inline __attribute__((always_inline)) void filtEnvStep32(Voice &v) {
    switch (v.filtStage) {
        case ENV_ATTACK:  v.filtEnv += envFAttInc * 32; if (v.filtEnv >= ENV_ONE) { v.filtEnv = ENV_ONE; v.filtStage = ENV_DECAY; } break;
        case ENV_DECAY:   v.filtEnv -= envFDecInc * 32; if (v.filtEnv <= 0) { v.filtEnv = 0; v.filtStage = ENV_IDLE; } break;
        case ENV_RELEASE: v.filtEnv -= envFDecInc * 32; if (v.filtEnv <= 0) { v.filtEnv = 0; v.filtStage = ENV_IDLE; } break;
        default: break;
    }
}

// Escolhe a voz para uma nota nova: livre > em release (a mais baixa) > a mais antiga.
// Uma voz "roubada" continua do nível e da fase em que estava, para não dar estalo.
void __not_in_flash_func(synthNoteOn)(uint8_t note, uint8_t vel) {
    int idx = -1;
    for (int i = 0; i < MAX_VOICES; i++) {
        if (!voices[i].active) { idx = i; break; }
    }
    bool stolen = false;
    if (idx < 0) {
        int32_t best = 0x7FFFFFFF;
        for (int i = 0; i < MAX_VOICES; i++) {
            if (voices[i].stage == ENV_RELEASE && voices[i].env < best) { best = voices[i].env; idx = i; }
        }
        if (idx < 0) {
            uint32_t oldestAge = 0xFFFFFFFFUL;
            for (int i = 0; i < MAX_VOICES; i++) {
                if (voices[i].age < oldestAge) { oldestAge = voices[i].age; idx = i; }
            }
        }
        stolen = true;
    }
    Voice &v = voices[idx];
    bool keep = stolen && (v.env > 0);
    v.active = true; v.note = note; v.velocity = vel;
    v.gainQ15 = ((int32_t)vel * 32768) / 127;
    if (!keep) {
        v.phase = 0; v.phase2 = 0; v.phase3 = 0; v.phaseSub = 0;
        v.env = 0; v.filtEnv = 0;
    }
    v.phaseInc = noteIncTable[note & 127];
    v.incEff = v.phaseInc;
    v.inc2 = v.phaseInc; v.inc3 = v.phaseInc;
    v.targetInc = v.phaseInc;
    v.stage = ENV_ATTACK;
    v.filtStage = ENV_ATTACK;
    v.pitchEnv = keep ? 0 : ENV_ONE;
    v.fmEnv = ENV_ONE;                       // o índice FM recomeça no máximo a cada nota
    if (!keep) {
        v.phaseFm = 0; v.fmPrev = 0; v.pmOff = 0; v.phaseO2 = 0;
        for (int k = 0; k < 5; k++) {          // fases iniciais diferentes por cópia do unison
            rngState ^= rngState << 13; rngState ^= rngState >> 17; rngState ^= rngState << 5;
            v.uph[k] = rngState;
        }
    }
    v.age = ++voiceCounter;
    lastVelocity = vel;
}

void __not_in_flash_func(synthNoteOff)(uint8_t note) {
    for (int i = 0; i < MAX_VOICES; i++) {
        if (voices[i].active && voices[i].note == note && voices[i].stage != ENV_RELEASE) {
            voices[i].stage = ENV_RELEASE;
            voices[i].filtStage = ENV_RELEASE;
        }
    }
}

void __not_in_flash_func(synthAllNotesOff)() {
    for (int i = 0; i < MAX_VOICES; i++) {
        if (voices[i].active && voices[i].stage != ENV_RELEASE) {
            voices[i].stage = ENV_RELEASE;
            voices[i].filtStage = ENV_RELEASE;
        }
    }
}

void __not_in_flash_func(synthGlide)(uint8_t oldNote, uint8_t newNote, uint8_t vel) {
    for (int i = 0; i < MAX_VOICES; i++) {
        if (voices[i].active && voices[i].note == oldNote && voices[i].stage != ENV_RELEASE) {
            voices[i].note = newNote;
            voices[i].velocity = vel;
            voices[i].gainQ15 = ((int32_t)vel * 32768) / 127;
            voices[i].targetInc = noteIncTable[newNote & 127];
            lastVelocity = vel;
            return;
        }
    }
    synthNoteOn(newNote, vel);
}

// ---------------- MODO DE VOZ (POLY / MONO / LEGATO) ----------------
static uint8_t monoStack[8];
static int     monoCount = 0;
static int     monoVoiceNote = -1;

static void monoRemove(uint8_t note) {
    for (int i = 0; i < monoCount; i++) {
        if (monoStack[i] == note) {
            for (int j = i; j < monoCount - 1; j++) monoStack[j] = monoStack[j + 1];
            monoCount--;
            return;
        }
    }
}

static void monoNoteOn(uint8_t note, uint8_t vel) {
    monoRemove(note);
    bool wasHeld = (monoCount > 0);
    if (monoCount < 8) {
        monoStack[monoCount++] = note;
    } else {
        for (int j = 0; j < 7; j++) monoStack[j] = monoStack[j + 1];
        monoStack[7] = note;
    }
    if (voiceMode == 2 && wasHeld && monoVoiceNote >= 0) {
        synthGlide((uint8_t)monoVoiceNote, note, vel);
    } else {
        if (monoVoiceNote >= 0) synthNoteOff((uint8_t)monoVoiceNote);
        synthNoteOn(note, vel);
    }
    monoVoiceNote = note;
}

static void monoNoteOff(uint8_t note) {
    bool wasSounding = (note == monoVoiceNote);
    monoRemove(note);
    if (monoCount == 0) {
        synthNoteOff(note);
        if (monoVoiceNote >= 0 && monoVoiceNote != note) synthNoteOff((uint8_t)monoVoiceNote);
        monoVoiceNote = -1;
        return;
    }
    if (wasSounding) {
        uint8_t back = monoStack[monoCount - 1];
        uint8_t vel = lastVelocity;
        if (voiceMode == 2) {
            synthGlide(note, back, vel);
        } else {
            synthNoteOff(note);
            synthNoteOn(back, vel);
        }
        monoVoiceNote = back;
    }
}

static void keyOn(uint8_t note, uint8_t vel) {
    if (voiceMode == 0) synthNoteOn(note, vel);
    else                monoNoteOn(note, vel);
}

static void keyOff(uint8_t note) {
    if (voiceMode == 0) synthNoteOff(note);
    else                monoNoteOff(note);
}

// ============================================================================
// SEQUENCIADOR (estilo TB-303) — clock interno ou MIDI clock externo
// ============================================================================
const int     SEQ_STEPS     = 16;
const uint8_t SEQ_BASE_NOTE = 36;  // C2

const int PATTERN_COUNT = 4;   // padrões A, B, C, D

SeqStep seqBank[PATTERN_COUNT][SEQ_STEPS] = {
  {
    {0,  0, true,  true,  false}, {0,  0, true,  false, false},
    {12, 0, true,  false, false}, {0,  0, false, false, false},
    {3,  0, true,  true,  false}, {0,  0, true,  false, false},
    {7,  0, true,  false, true }, {10, 0, true,  false, false},
    {0,  0, true,  true,  false}, {0,  0, false, false, false},
    {12, 0, true,  false, false}, {0,  0, true,  false, false},
    {5,  0, true,  true,  false}, {3,  0, true,  false, true },
    {7,  0, true,  false, false}, {0,  0, true,  false, false}
  }
};
SeqStep *seq = seqBank[0];     // padrão que está sendo EDITADO na tela

void seqInitBanks() {          // B, C e D começam como cópia do A
    for (int p = 1; p < PATTERN_COUNT; p++) memcpy(seqBank[p], seqBank[0], sizeof(seqBank[0]));
}

volatile uint8_t seqEditPat = 0;     // padrão mostrado/editado
volatile uint8_t seqCuePat  = 0;     // padrão que toca (chain desligada)
volatile uint8_t seqPlayPat = 0;     // padrão do passo que está tocando
volatile bool    seqChainOn = false;
uint8_t          seqChain[8] = {0, 1, 2, 3, 0, 1, 2, 3};
volatile uint8_t seqChainLen = 4;
volatile uint8_t seqChainPos = 0;      // posição tocando agora (para a tela)
volatile uint8_t seqChainNextPos = 0;  // posição do próximo compasso
static uint8_t   seqNextPat = 0;
static uint8_t   seqBarCount = 0;
// ratchet / gate
static uint8_t   seqRatN = 1, seqRatLeft = 0, seqStepVel = 80;
static int32_t   seqSubLen = 0, seqRatNextAt = 0, seqGateEndAt = 0;

int seqBpm = 120;
volatile uint32_t seqStepLen = 4000;
volatile uint8_t  seqCmd = 0;
volatile bool     seqRunning = false;
volatile int      seqPlayStep = -1;
volatile int      seqAuditionReq = -1;
volatile uint8_t  seqMode = 0;
volatile bool     seqRecArm = false;
volatile bool     seqSyncExt = false;
volatile bool     settingsDirty = false;

volatile int      seqEditStep = 0;
volatile uint16_t seqRedrawMask = 0;
volatile bool     seqEditorDirty = false;

uint32_t seqCounter = 0;
bool     seqGateOpen = false;
bool     seqNoteHeld = false;
int      seqHeldNote = 0;
int      seqAuditionNote = 0;
uint32_t seqAuditionCount = 0;
static int32_t seqCurStepLen = 4000, seqCurGateLen = 2400;
static int     seqNextStepVal = 0, seqDir = 1;
static bool    seqParity = false;
static bool     seqStepPending = false;
static int      extPulse = 0;
static uint32_t extSamples = 0;
static int32_t  extStepLen = 4000;

int __not_in_flash_func(seqNoteOf)(const SeqStep &st) {
    int n = (int)SEQ_BASE_NOTE + st.oct * 12 + st.semi;
    if (n < 0) n = 0;
    if (n > 127) n = 127;
    return n;
}

// nota do passo i do padrão EDITADO (usado pela tela)
int __not_in_flash_func(seqStepNote)(int i) { return seqNoteOf(seq[i]); }

void seqUpdateTiming() {
    seqStepLen = (uint32_t)((float)SAMPLE_RATE * 60.0f / ((float)seqBpm * 4.0f));
}

void __not_in_flash_func(seqTriggerStep)(int s) {
    SeqStep &st = seqBank[seqPlayPat & 3][s];
    seqRatLeft = 0; seqRatN = 1;
    bool play = st.gate;
    if (play && st.probIdx > 0) {
        rngState ^= rngState << 13;
        rngState ^= rngState >> 17;
        rngState ^= rngState << 5;
        // chance 100/75/50/25% -> toca se r < 128/96/64/32
        if ((int)((rngState >> 8) & 127) >= 128 - (int)(st.probIdx & 3) * 32) play = false;
    }
    if (!play) {
        if (seqNoteHeld) { synthNoteOff(seqHeldNote); seqNoteHeld = false; }
        seqGateOpen = false;
        return;
    }
    int note = seqNoteOf(st);
    uint8_t vel = st.accent ? 127 : 80;
    if (st.accent) {                         // accent 303: cada accent carrega o "capacitor" do filtro
        accentEnvQ15 += pAccentQ15;
        if (accentEnvQ15 > 49152) accentEnvQ15 = 49152;
    }
    if (seqNoteHeld) synthGlide(seqHeldNote, note, vel);
    else             synthNoteOn(note, vel);
    seqHeldNote = note;
    seqNoteHeld = true;
    seqGateOpen = true;
    seqStepVel = vel;
    seqRatN = (uint8_t)((st.ratchIdx & 3) + 1);
    if (seqRatN > 1) {
        seqSubLen = seqCurStepLen / seqRatN;
        seqRatLeft = (uint8_t)(seqRatN - 1);
        seqRatNextAt = seqSubLen;
        seqGateEndAt = (seqSubLen * 6) / 10;
    } else {
        seqGateEndAt = seqCurGateLen;
    }
}

// dispara as repetições (ratchet) dentro do passo
static inline void __not_in_flash_func(seqRatchetTick)() {
    if (seqRatLeft > 0 && (int32_t)seqCounter >= seqRatNextAt) {
        int32_t start = seqRatNextAt;
        seqRatLeft--;
        seqRatNextAt += seqSubLen;
        if (seqNoteHeld) synthNoteOff(seqHeldNote);
        synthNoteOn(seqHeldNote, (uint8_t)((seqStepVel * 7) >> 3));
        seqNoteHeld = true;
        seqGateOpen = true;
        seqGateEndAt = start + (seqSubLen * 6) / 10;
    }
}

void __not_in_flash_func(seqGateEnd)(int s) {
    seqGateOpen = false;
    if (seqRatLeft == 0) {   // só a última repetição pode deslizar (slide) para o próximo passo
        int next = seqNextStepVal;
        if (seqBank[seqPlayPat & 3][s].slide && seqBank[seqNextPat & 3][next].gate) return;
    }
    synthNoteOff(seqHeldNote);
    seqNoteHeld = false;
}

void __not_in_flash_func(seqStopInternal)() {
    seqRunning = false;
    seqRatLeft = 0;
    if (seqNoteHeld) { synthNoteOff(seqHeldNote); seqNoteHeld = false; }
    seqGateOpen = false;
    seqPlayStep = -1;
}

static int __not_in_flash_func(seqComputeNext)(int cur) {
    switch (seqMode) {
        case 1: return (cur + 15) & 15;
        case 2: {
            int n = cur + seqDir;
            if (n > 15) { seqDir = -1; n = 14; }
            else if (n < 0) { seqDir = 1; n = 1; }
            return n;
        }
        case 3: {
            rngState ^= rngState << 13;
            rngState ^= rngState >> 17;
            rngState ^= rngState << 5;
            return (int)((rngState >> 8) & 15);
        }
        default: return (cur + 1) & 15;
    }
}

static void __not_in_flash_func(seqPrepareStart)() {
    seqPlayStep = -1; seqCounter = 0; seqParity = false; seqDir = 1;
    if (lfoSync) lfoPhase32 = 0;          // LFO sincronizado começa junto com o sequenciador
    if (seqMode == 1)      seqNextStepVal = 15;
    else if (seqMode == 3) seqNextStepVal = (int)((rngState >> 8) & 15);
    else                   seqNextStepVal = 0;
    extPulse = 0; seqStepPending = false; extSamples = 0; extStepLen = (int32_t)seqStepLen;
    seqRatLeft = 0; seqGateEndAt = 0;
    seqBarCount = 0; seqChainPos = 0; seqChainNextPos = 0;
    seqNextPat = seqChainOn ? (uint8_t)(seqChain[0] & 3) : (uint8_t)(seqCuePat & 3);
    seqPlayPat = seqNextPat;
}

// escolhe o padrão do próximo compasso (chain ou padrão selecionado)
static uint8_t __not_in_flash_func(seqPickNextPat)() {
    if (seqChainOn) {
        uint8_t n = seqChainLen;
        if (n < 1) n = 1;
        if (n > 8) n = 8;
        uint8_t p = (uint8_t)(seqChainNextPos + 1);
        if (p >= n) p = 0;
        seqChainNextPos = p;
        return (uint8_t)(seqChain[p] & 3);
    }
    return (uint8_t)(seqCuePat & 3);
}

static void __not_in_flash_func(seqBeginStep)() {
    seqPlayStep = seqNextStepVal;
    seqPlayPat = seqNextPat;
    if (seqBarCount == 0) seqChainPos = seqChainNextPos;
    seqTriggerStep(seqPlayStep);
    seqNextStepVal = seqComputeNext(seqPlayStep);
    if (++seqBarCount >= SEQ_STEPS) { seqBarCount = 0; seqNextPat = seqPickNextPat(); }
}

void __not_in_flash_func(seqTick)() {
    if (seqAuditionReq >= 0) {
        seqAuditionNote = seqAuditionReq;
        seqAuditionReq = -1;
        synthNoteOn((uint8_t)seqAuditionNote, 100);
        seqAuditionCount = SAMPLE_RATE / 6;
    }
    if (seqAuditionCount > 0) {
        if (--seqAuditionCount == 0) synthNoteOff((uint8_t)seqAuditionNote);
    }

    if (seqCmd) {
        uint8_t c = seqCmd; seqCmd = 0;
        if (c == 1) { seqPrepareStart(); seqRunning = true; }
        else        { seqStopInternal(); }
    }
    if (!seqRunning) return;

    if (seqSyncExt) {
        if (seqStepPending) {
            seqStepPending = false;
            if (extSamples > 400 && extSamples < 60000) {
                extStepLen = (extStepLen * 3 + (int32_t)extSamples) >> 2;
                seqBpm = constrain((int)(480000 / extStepLen), 40, 300);
            }
            extSamples = 0;
            seqCounter = 0;
            seqCurStepLen = extStepLen;
            seqCurGateLen = (extStepLen * 6) / 10;
            seqBeginStep();
        } else {
            seqRatchetTick();
            if (seqGateOpen && (int32_t)seqCounter >= seqGateEndAt) seqGateEnd(seqPlayStep);
        }
        seqCounter++;
        extSamples++;
        return;
    }

    if (seqCounter == 0) {
        int32_t off =(int32_t)(((uint32_t)seqStepLen * (uint32_t)pSwingQ8) >> 8);
        seqCurStepLen = seqParity ? ((int32_t)seqStepLen - off) : ((int32_t)seqStepLen + off);
        if (seqCurStepLen < 8) seqCurStepLen = 8;
        seqParity = !seqParity;
        seqCurGateLen = (seqCurStepLen * 6) / 10;
        seqBeginStep();
    } else {
        seqRatchetTick();
        if (seqGateOpen && (int32_t)seqCounter >= seqGateEndAt) seqGateEnd(seqPlayStep);
    }
    seqCounter++;
    if ((int32_t)seqCounter >= seqCurStepLen) seqCounter = 0;
}

void seqRecordNote(uint8_t note, uint8_t vel) {
    int target;
    if (seqRunning) {
        int cur = seqPlayStep; if (cur < 0) cur = 0;
        target = ((int32_t)seqCounter > seqCurStepLen / 2) ? seqNextStepVal : cur;
    } else {
        target = seqEditStep;
    }
    target &= 15;

    int n = (int)note - (int)SEQ_BASE_NOTE;
    int oct = (n >= 0) ? (n / 12) : -((-n + 11) / 12);
    if (oct < -1) oct = -1;
    if (oct > 2)  oct = 2;
    int semi = n - oct * 12;
    if (semi < 0) semi = 0;
    if (semi > 12) semi = 12;

    seq[target].semi = (uint8_t)semi;
    seq[target].oct = (int8_t)oct;
    seq[target].gate = true;
    seq[target].accent = (vel >= 100);

    uint16_t mask = (uint16_t)(1u << target);
    if (!seqRunning) {
        int old = seqEditStep;
        int nxt = (target + 1) & 15;
        seqEditStep = nxt;
        mask |= (uint16_t)((1u << old) | (1u << nxt));
        seqEditorDirty = true;
    } else if (target == seqEditStep) {
        seqEditorDirty = true;
    }
    seqRedrawMask |= mask;
}

// ============================================================================
// PADS DO APC -> PASSOS DO SEQUENCIADOR
// ============================================================================
const int     PAD_COUNT    = 17;
const int     PAD_MAP_ADDR = 1400;
const uint8_t PAD_MAGIC    = 0x5C;

uint8_t padCh[PAD_COUNT];
uint8_t padNote[PAD_COUNT];
volatile int8_t padLearnIdx = -1;
volatile bool   padMapDirty = false;

bool padsMapped() {
    for (int i = 0; i < PAD_COUNT; i++) if (padCh[i] != 0) return true;
    return false;
}

int padFind(byte ch, byte note) {
    for (int i = 0; i < PAD_COUNT; i++) {
        if (padCh[i] != 0 && padCh[i] == ch && padNote[i] == note) return i;
    }
    return -1;
}

void padLearnCapture(byte ch, byte note) {
    int idx = padLearnIdx;
    if (idx < 0 || idx >= PAD_COUNT) return;
    for (int i = 0; i < PAD_COUNT; i++) {
        if (padCh[i] == ch && padNote[i] == note) padCh[i] = 0;
    }
    padCh[idx] = ch;
    padNote[idx] = note;
    if (idx + 1 >= PAD_COUNT) { padLearnIdx = -1; padMapDirty = true; }
    else                      { padLearnIdx = idx + 1; }
}

void padPressed(int idx) {
    if (idx == 16) {
        seqCmd = seqRunning ? 2 : 1;
        return;
    }
    int old = seqEditStep;
    seq[idx].gate = !seq[idx].gate;
    seqEditStep = idx;
    seqRedrawMask |= (uint16_t)((1u << old) | (1u << idx));
    seqEditorDirty = true;
    if (!seqRunning && seq[idx].gate) seqAuditionReq = seqStepNote(idx);
}

// ============================================================================
// EFEITOS: BITCRUSHER -> CHORUS -> DELAY PING-PONG -> REVERB (tudo em inteiros)
// Delay e reverb não processam nada quando o MIX está em 0 (e começam limpos ao ligar).
// ============================================================================
#define ENABLE_FX 1   // mude para 0 para testar o som sem os efeitos

static inline __attribute__((always_inline)) int16_t clamp16(int32_t v) {
    return (v > 32767) ? (int16_t)32767 : ((v < -32768) ? (int16_t)-32768 : (int16_t)v);
}

static inline __attribute__((always_inline)) int32_t softLimit(int32_t x) {
    const int32_t T = 24000;
    if (x > T)       { x = T + ((x - T) >> 2);  if (x > 32767)  x = 32767; }
    else if (x < -T) { x = -T + ((x + T) >> 2); if (x < -32768) x = -32768; }
    return x;
}

const int DELAY_MAX = 16000;
static int16_t delayBufL[DELAY_MAX];
static int16_t delayBufR[DELAY_MAX];
static int delayWrite = 0;
static int delayCur = 8000;
static int delayTarget = 8000;
static uint32_t delaySlewCount = 0;
static bool dlyWasOn = false, revWasOn = false;

// reverb: 8 filtros comb compartilhados (L lê o ponto de escrita, R lê um 2º ponto) + 4 allpass por lado
static int COMB_LEN[8] = {810, 862, 927, 984, 1032, 1082, 1130, 1173};
static int COMB_TAP[8] = {271, 288, 309, 328, 344, 361, 377, 391};
static int AP_LEN[4]   = {403, 320, 247, 163};
const int STEREO_SPREAD = 17;
static int16_t combBuf[8][1190];
static int     combIdx[8];
static int32_t combStore[8];
static int16_t apBufL[4][420];
static int16_t apBufR[4][420];
static int     apIdxL[4], apIdxR[4];

static int32_t fxDelayFb = 0, fxDelayMix = 0;
static int32_t fxRevFb = 0, fxRevDamp = 0, fxRevMix = 0;

// chorus (1024 amostras = 32 ms) e bitcrusher
static int16_t  choBuf[1024];
static int      choW = 0;
static uint32_t choPhase = 0, choInc = 0;
static int32_t  choDepthQ8 = 0, choMixQ15 = 0;
static int32_t  crMixQ15 = 0, crHold = 0, crHalf = 0;
static int      crShift = 0, crFactor = 1, crCount = 0;

void fxUpdateParams() {
    fxDelayFb  = (int32_t)(constrain(paramDelayFb, 0.0f, 0.92f) * 32768.0f);
    fxDelayMix = (int32_t)(constrain(paramDelayMix, 0.0f, 0.999f) * 32768.0f);
    delayTarget = constrain((int)(paramDelayTime * 0.001f * (float)SAMPLE_RATE), 1, DELAY_MAX - 1);
    fxRevFb    = (int32_t)((0.70f + constrain(paramRevSize, 0.0f, 1.0f) * 0.25f) * 32768.0f);
    fxRevDamp  = (int32_t)(constrain(paramRevDamp, 0.0f, 1.0f) * 0.5f * 32768.0f);
    fxRevMix   = (int32_t)(constrain(paramRevMix, 0.0f, 0.999f) * 32768.0f);

    choInc     = (uint32_t)(constrain(paramChoRate, 0.1f, 5.0f) * 134217.728f);
    choDepthQ8 = (int32_t)(constrain(paramChoDepth, 0.0f, 1.0f) * 40960.0f);
    choMixQ15  = (int32_t)(constrain(paramChoMix, 0.0f, 1.0f) * 32767.0f);

    int bits = constrain((int)(paramCrBits + 0.5f), 4, 16);
    crShift  = 16 - bits;
    crHalf   = (crShift > 0) ? (1 << (crShift - 1)) : 0;
    crFactor = constrain((int)(paramCrRate + 0.5f), 1, 24);
    crMixQ15 = (int32_t)(constrain(paramCrMix, 0.0f, 1.0f) * 32767.0f);
}

static void clearReverbState() {
    memset(combBuf, 0, sizeof(combBuf));
    memset(apBufL, 0, sizeof(apBufL));
    memset(apBufR, 0, sizeof(apBufR));
    memset(combIdx, 0, sizeof(combIdx));
    memset(combStore, 0, sizeof(combStore));
    memset(apIdxL, 0, sizeof(apIdxL));
    memset(apIdxR, 0, sizeof(apIdxR));
}

static void clearDelayState() {
    memset(delayBufL, 0, sizeof(delayBufL));
    memset(delayBufR, 0, sizeof(delayBufR));
    delayWrite = 0;
    delayCur = delayTarget;
}

// leitura do chorus com interpolação linear (atraso em Q8 amostras)
static inline __attribute__((always_inline)) int32_t choRead(int32_t dQ8) {
    int32_t pos = ((int32_t)choW << 8) - dQ8;
    pos &= 0x3FFFF;
    int i0 = pos >> 8;
    int fr = pos & 255;
    int i1 = (i0 + 1) & 1023;
    return ((int32_t)choBuf[i0] * (256 - fr) + (int32_t)choBuf[i1] * fr) >> 8;
}

static void __not_in_flash_func(fxProcess)(int32_t dry, int32_t &outL, int32_t &outR) {
    int32_t x = dry;

    // ---------- BITCRUSHER (mono) ----------
    if (crMixQ15 > 0) {
        if (++crCount >= crFactor) {
            crCount = 0;
            int32_t q = x;
            if (crShift > 0) {
                q = ((x + crHalf) >> crShift) << crShift;
                if (q > 32767) q = 32767;
            }
            crHold = q;
        }
        x = x + (((crHold - x) * crMixQ15) >> 15);
    }

    // ---------- CHORUS (estéreo, LFOs em oposição) ----------
    int32_t l = x, r = x;
    choBuf[choW] = (int16_t)clamp16(x);
    if (choMixQ15 > 0) {
        int32_t lfoL = sineTable[choPhase >> 24];
        int32_t lfoR = sineTable[(uint32_t)(choPhase + 0x80000000u) >> 24];
        const int32_t base = 122880;                       // 15 ms em Q8
        int32_t tapL = choRead(base + ((lfoL * choDepthQ8) >> 15));
        int32_t tapR = choRead(base + ((lfoR * choDepthQ8) >> 15));
        l = x + (((tapL - x) * choMixQ15) >> 16);
        r = x + (((tapR - x) * choMixQ15) >> 16);
    }
    choPhase += choInc;
    choW = (choW + 1) & 1023;
    int32_t mono = (l + r) >> 1;

    // ---------- DELAY (ping-pong) ----------
    if (fxDelayMix > 0) {
        if (!dlyWasOn) { clearDelayState(); dlyWasOn = true; }
        if ((++delaySlewCount & 15) == 0) {
            int diff = delayTarget - delayCur;
            int step = diff / 128;
            if (step == 0) step = (diff > 0) ? 1 : ((diff < 0) ? -1 : 0);
            delayCur += step;
        }
        int rp = delayWrite - delayCur;
        if (rp < 0) rp += DELAY_MAX;
        int32_t dl = delayBufL[rp];
        int32_t dr = delayBufR[rp];
        delayBufL[delayWrite] = clamp16(mono + ((dr * fxDelayFb) >> 15));
        delayBufR[delayWrite] = clamp16((dl * fxDelayFb) >> 15);
        if (++delayWrite >= DELAY_MAX) delayWrite = 0;
        l += (dl * fxDelayMix) >> 15;
        r += (dr * fxDelayMix) >> 15;
    } else {
        dlyWasOn = false;
    }

    // ---------- REVERB ----------
    if (fxRevMix > 0) {
        if (!revWasOn) { clearReverbState(); revWasOn = true; }
        int32_t rin = (l + r) >> 6;
        int32_t accL = 0, accR = 0;
        for (int i = 0; i < 8; i++) {
            int idx = combIdx[i];
            int len = COMB_LEN[i];
            int32_t o = combBuf[i][idx];
            int j = idx + COMB_TAP[i];
            if (j >= len) j -= len;
            int32_t oR = combBuf[i][j];
            combStore[i] = o + ((((combStore[i] - o) * fxRevDamp) + 16384) >> 15);
            combBuf[i][idx] = clamp16(rin + (((combStore[i] * fxRevFb) + 16384) >> 15));
            if (++idx >= len) idx = 0;
            combIdx[i] = idx;
            accL += o;
            accR += oR;
        }
        for (int i = 0; i < 4; i++) {
            int32_t b = apBufL[i][apIdxL[i]];
            int32_t o = b - accL;
            apBufL[i][apIdxL[i]] = clamp16(accL + (b >> 1));
            if (++apIdxL[i] >= AP_LEN[i]) apIdxL[i] = 0;
            accL = o;

            b = apBufR[i][apIdxR[i]];
            o = b - accR;
            apBufR[i][apIdxR[i]] = clamp16(accR + (b >> 1));
            if (++apIdxR[i] >= AP_LEN[i] + STEREO_SPREAD) apIdxR[i] = 0;
            accR = o;
        }
        l += ((accL >> 2) * (fxRevMix >> 2)) >> 9;
        r += ((accR >> 2) * (fxRevMix >> 2)) >> 9;
    } else {
        revWasOn = false;
    }

    outL = l;
    outR = r;
}

// ---- Estado de controle do áudio ----
static int32_t fCur22 = 3000 << 8, qCur22 = 12000 << 8;       // coeficientes do filtro suavizados (Q22)
static int32_t fTarget22 = 3000 << 8, qTarget22 = 12000 << 8;
static uint8_t ctrlTick = 0;
static int32_t selfWetQ15 = 0;
static bool    seedOn = false;
static int32_t vcaQ15 = 0;

static int32_t MIX_GAIN_Q15[5] = {32768, 32768, 23170, 18918, 16384};
static int32_t mixGainQ15 = 32768;

// multiplicação (estado Q8) x (coeficiente Q14) sem estourar 32 bits, com arredondamento
static inline __attribute__((always_inline)) int32_t mulQ14(int32_t s, int32_t c) {
    return ((((s >> 8) * c) + 32) >> 6) + ((((s & 255) * c) + 8192) >> 14);
}

// uma linha da matriz (destino d): soma das 4 fontes x quantidades
static inline __attribute__((always_inline)) int32_t mmRow(int d, int32_t s0, int32_t s1, int32_t s2, int32_t s3) {
    return ((s0 * pMmQ15[d * 4 + 0]) >> 15) + ((s1 * pMmQ15[d * 4 + 1]) >> 15)
         + ((s2 * pMmQ15[d * 4 + 2]) >> 15) + ((s3 * pMmQ15[d * 4 + 3]) >> 15);
}

const int32_t FILTER2_Q14 = 18842;   // amortecimento fixo do 2º estágio (1,15)

// Gera até 96 amostras e devolve quantas foram geradas (para o medidor de CPU).
// Aqui dentro NÃO há nenhuma conta de float: tudo é inteiro e roda da RAM.
int __not_in_flash_func(audioProcess)() {
    int budget = 96;
    int produced = 0;

    // parâmetros publicados lidos uma vez por chamada
    const uint8_t fm = filtMode;
    const bool    isSuper = (currentWave == WAVE_SUPERSAW);
    const bool    isWt    = (currentWave == WAVE_TABLE);
    const bool    driveOn = pDriveOn;
    const int32_t driveGain = pDriveGainQ8, driveComp = pDriveCompQ15;
    const int32_t mainGain = pMainGainQ15, subGain = pSubGainQ15;
    const bool    subOn = (subGain > 200);
    const int32_t spreadQ16 = pSpreadQ16;
    const int     gsh = pGlideShift;
    const bool    pitchOn = pPitchOn;
    const int32_t pitchDec = pPitchDecInc;
    const uint32_t *ptab = pitchMulTbl[pitchTblSel];
    const int32_t volQ = volQ15;
    const bool    slope24 = (filtSlope != 0);
    const bool    pmOn = pPitchModOn;
    const bool    mmOn = pMmOn;
    const bool    o2On = pO2On, o2SyncOn = pO2Sync;
    const int32_t o2MulQ8 = pO2MulQ8, o2Main = pO2MainQ15, o2Gain = pO2GainQ15;
    const uint8_t o2w = o2Wave;
    const bool    ringOn = o2Ring;
    const bool    foldOn = pFoldOn;
    const int32_t foldGain = pFoldGainQ8;
    const int     uniCnt = pUniN;
    const bool    uniOn = (uniCnt > 1) && !isSuper && (currentWave != WAVE_NOISE);
    const int32_t uniGain = pUniGainQ15;
    int32_t       uniSpread[5];
    for (int k = 0; k < 5; k++) uniSpread[k] = pUniSpreadQ16[k];
    const bool    fmOn = pFmOn;
    const int32_t fmIdx = pFmIdxQ12, fmRatio = pFmRatioQ8, fmEnvAmt = pFmEnvQ15, fmFb = pFmFbQ12, fmDec = pFmDecInc;

    const int32_t KNEE = 20000 << 8;
    const int32_t LIM  = (65535 << 8);

    while (budget-- > 0 && i2s.availableForWrite() >= 2) {
        seqTick();

        // ---------- controle: 1 a cada 32 amostras (1 kHz), só inteiros ----------
        if ((ctrlTick++ & 31) == 0) {
            const uint32_t lfoOld = lfoPhase32;
            lfoPhase32 += (pLfoInc32 << 5);
            int32_t lfoRaw;                                               // Q15, -32768..32767
            switch (lfoShape) {
                case 1:  lfoRaw = (int32_t)(((lfoPhase32 & 0x80000000u) ? ~lfoPhase32 : lfoPhase32) >> 15) - 32768; break;
                case 2:  lfoRaw = (int32_t)(lfoPhase32 >> 16) - 32768; break;
                case 3:  lfoRaw = (lfoPhase32 & 0x80000000u) ? 32767 : -32767; break;
                case 4:                                                   // novo valor aleatório a cada ciclo
                    if (lfoPhase32 < lfoOld) {
                        rngState ^= rngState << 13; rngState ^= rngState >> 17; rngState ^= rngState << 5;
                        lfoHold = (int32_t)(int16_t)(rngState >> 16);
                    }
                    lfoRaw = lfoHold;
                    break;
                default: lfoRaw = sineTable[lfoPhase32 >> 24]; break;
            }

            int32_t fsum = 0, asum = 0, fcnt = 0;
            for (int i = 0; i < MAX_VOICES; i++) {
                Voice &v = voices[i];
                if (!v.active) continue;
                filtEnvStep32(v);
                fsum += v.filtEnv;
                asum += v.env;
                fcnt++;
            }
            int32_t envAvgQ15 = (fcnt > 0) ? ((fsum / fcnt) >> 9) : 0;
            int32_t ampAvgQ15 = (fcnt > 0) ? ((asum / fcnt) >> 9) : 0;
            int32_t velQ15 = (int32_t)lastVelocity * 258 - 16384;

            // ---- matriz de modulação (fontes Q15 x quantidade Q15) ----
            int32_t mCut = 0, mPit = 0, mPwm = 0, mVol = 0;
            if (mmOn) {
                const int32_t s0 = lfoRaw, s1 = envAvgQ15, s2 = ampAvgQ15, s3 = (int32_t)lastVelocity * 258;
                mCut = mmRow(0, s0, s1, s2, s3);
                mPit = mmRow(1, s0, s1, s2, s3);
                mPwm = mmRow(2, s0, s1, s2, s3);
                mVol = mmRow(3, s0, s1, s2, s3);
            }
            if (pmOn) {
                if (mPit > 32768) mPit = 32768;
                if (mPit < -32768) mPit = -32768;
                uint32_t pos = (uint32_t)(mPit + 32768);          // 0..65536
                uint32_t ti = pos >> 9, fr = pos & 511;
                uint32_t ta = pitchModTbl[ti], tb = pitchModTbl[(ti < 128) ? ti + 1 : 128];
                pitchModMul = ta + (uint32_t)((((int32_t)(tb - ta)) * (int32_t)fr) >> 9);
            } else {
                pitchModMul = 65536;
            }
            int32_t gv = 32768 + mVol;
            if (gv < 0) gv = 0;
            if (gv > 49152) gv = 49152;
            volTargetQ15 = (volQ * gv) >> 15;

            int32_t pw = pPwmBaseQ16 + ((lfoRaw * pPwmModQ16) >> 15) + ((mPwm * 26214) >> 15);   // largura do pulso (Q16)
            if (pw < 3277)  pw = 3277;
            if (pw > 62259) pw = 62259;
            pulseWQ32 = (uint32_t)pw << 16;

            // posição da wavetable: base + LFO + linha "PWM/WT" da matriz (env a 100% varre a tabela toda)
            int32_t wp = pWtPosQ16 + ((lfoRaw * pWtLfoQ15) >> 15) + mPwm * 2;
            if (wp < 0)     wp = 0;
            if (wp > 65535) wp = 65535;
            wtPosTarget = wp;

            accentEnvQ15 -= (accentEnvQ15 >> 7) + (accentEnvQ15 > 0 ? 1 : 0);   // accent descarrega (~130 ms)
            int32_t m = pCutBaseQ15
                      + ((lfoRaw * pLfoHalfQ15) >> 15)
                      + ((envAvgQ15 * pFiltAmtQ15) >> 15)
                      + ((velQ15 * pVelFiltQ15) >> 15)
                      + mCut
                      + (accentEnvQ15 >> 1);                     // accent 303
            if (m < 328)   m = 328;
            if (m > 32768) m = 32768;
            fTarget22 = (int32_t)fTableQ14[m >> 5] * 256;
            qTarget22 = pQTargetQ14 * 256;
            selfWetQ15 = pSelfWetQ15;
            seedOn = pSeedOn;
        }

        // suavização por amostra dos coeficientes do filtro
        fCur22 += (fTarget22 - fCur22) >> 6;
        qCur22 += (qTarget22 - qCur22) >> 6;
        const int32_t fF = fCur22 >> 8;
        const int32_t qF = qCur22 >> 8;

        if (isWt) {                                     // morph suavizado por amostra (sem degraus a 1 kHz)
            wtPosCur += (wtPosTarget - wtPosCur) >> 6;
            uint32_t p7 = (uint32_t)wtPosCur * 7u;
            wtFrame = (int)(p7 >> 16);
            wtFracQ14 = (int32_t)((p7 & 0xFFFF) >> 2);
        }

        // ---------- vozes ----------
        int32_t mixSum = 0;
        int32_t activeCount = 0;
        int32_t heldCount = 0;
        int32_t envMaxQ24 = 0;

        for (int i = 0; i < MAX_VOICES; i++) {
            Voice &v = voices[i];
            if (!v.active) continue;
            ampEnvStep(v);
            if (!v.active) continue;

            if (v.phaseInc != v.targetInc) {
                int32_t d = (int32_t)(v.targetInc - v.phaseInc);
                int32_t th = 1 << gsh;
                if (d > -th && d < th) v.phaseInc = v.targetInc;
                else v.phaseInc += (d >> gsh);
            }

            uint32_t incEff = v.phaseInc;
            if (pitchOn && v.pitchEnv > 0) {
                v.pitchEnv -= pitchDec;
                if (v.pitchEnv < 0) v.pitchEnv = 0;
                uint64_t t = ((uint64_t)v.phaseInc * (uint64_t)ptab[v.pitchEnv >> 17]) >> 16;
                incEff = (t > 0x7FFFFFFFull) ? 0x7FFFFFFFu : (uint32_t)t;
            }
            if (pmOn) {
                uint64_t t2 = ((uint64_t)incEff * (uint64_t)pitchModMul) >> 16;
                incEff = (t2 > 0x7FFFFFFFull) ? 0x7FFFFFFFu : (uint32_t)t2;
            }
            v.incEff = incEff;

            if (isSuper) {
                uint32_t d = (((incEff >> 10) * (uint32_t)spreadQ16) >> 6);
                v.inc2 = incEff + d;
                v.inc3 = incEff - d;
            }

            // ---- FM: modulador seno na razão escolhida desvia a fase da portadora ----
            if (fmOn) {
                int32_t m = sineInterp(v.phaseFm + ((uint32_t)(v.fmPrev * fmFb) << 5));   // feedback
                v.fmPrev = m;
                v.phaseFm += (incEff >> 8) * (uint32_t)fmRatio;                           // segue o pitch da voz
                if (v.fmEnv > 0) { v.fmEnv -= fmDec; if (v.fmEnv < 0) v.fmEnv = 0; }
                int32_t eQ15 = (32768 - fmEnvAmt) + (((v.fmEnv >> 9) * fmEnvAmt) >> 15);
                int32_t idx = (fmIdx * eQ15) >> 15;                                       // Q12 ciclos
                v.pmOff = (uint32_t)(m * idx) << 5;
            } else {
                v.pmOff = 0;
            }
            int32_t s;
            if (uniOn) {                         // UNISON: várias cópias desafinadas da mesma onda
                int32_t acc = 0;
                for (int k = 0; k < uniCnt; k++) {
                    int32_t sp = uniSpread[k];
                    uint32_t dk = ((incEff >> 10) * (uint32_t)((sp < 0) ? -sp : sp)) >> 6;
                    uint32_t ik = (sp < 0) ? (incEff - dk) : (incEff + dk);
                    acc += oscSampleAt(v.uph[k] + v.pmOff, ik);
                    v.uph[k] += ik;
                }
                s = ((acc >> 1) * uniGain) >> 14;
            } else {
                s = oscSample(v);
            }
            if (o2On) {                          // OSC2: segue o pitch da voz + semitons/cents
                uint32_t i2 = (incEff >> 8) * (uint32_t)o2MulQ8;
                int32_t s2 = osc2Sample(v.phaseO2, i2, o2w);
                v.phaseO2 += i2;
                if (ringOn) s2 = (s * s2) >> 15;      // ring mod: OSC1 x OSC2
                s = ((s * o2Main) + (s2 * o2Gain)) >> 15;
            }
            if (subOn) {
                int32_t sb = subSample(v.phaseSub, incEff >> 1);
                s = ((s * mainGain) + (sb * subGain)) >> 15;
            }
            int32_t amp = ((v.env >> 9) * v.gainQ15) >> 15;
            mixSum += (s * amp) >> 15;
            if (v.env > envMaxQ24) envMaxQ24 = v.env;
            if (v.stage != ENV_RELEASE && v.stage != ENV_IDLE) heldCount++;

            {
                uint32_t oldPh = v.phase;
                v.phase += incEff;
                // hard sync: o OSC2 reinicia quando o OSC1 completa um ciclo
                if (o2SyncOn && o2On && v.phase < oldPh) v.phaseO2 = (v.phase >> 8) * (uint32_t)o2MulQ8;
            }
            if (isSuper) {
                v.phase2 += v.inc2;
                v.phase3 += v.inc3;
            }
            if (subOn) v.phaseSub += (incEff >> 1);
            activeCount++;
        }

        int32_t gTarget = MIX_GAIN_Q15[(heldCount > 4) ? 4 : heldCount];
        mixGainQ15 += (gTarget - mixGainQ15) >> 8;
        int32_t in = ((mixSum >> 2) * mixGainQ15) >> 13;
        if (in > 65535)  in = 65535;
        if (in < -65535) in = -65535;

        // ---------- drive (saturação cúbica antes do filtro, em inteiros) ----------
        // ---------- wavefolder: o que passa do limite é dobrado de volta ----------
        if (foldOn) {
            int32_t x = (in * foldGain) >> 8;
            int32_t p = (x + 65536) & 262143;                   // período de 4 x 65536
            if (p > 131072) p = 262144 - p;
            in = p - 65536;
            if (in > 65535) in = 65535;
        }

        if (driveOn) {
            int32_t x = (in * driveGain) >> 8;
            if (x > 32768)  x = 32768;
            if (x < -32768) x = -32768;
            int32_t x2 = (x * x) >> 15;
            int32_t x3 = (x2 * x) >> 15;
            int32_t y = x - ((x3 * 10923) >> 15);
            in = (y * driveComp) >> 15;
        }

        // ---------- filtro SVF em ponto fixo (LP / BP / HP, com auto-oscilação) ----------
        if (seedOn && activeCount > 0) {
            rngState ^= rngState << 13;
            rngState ^= rngState >> 17;
            rngState ^= rngState << 5;
            in += ((int32_t)(int16_t)(rngState >> 16)) >> 8;
        }
        const int32_t in8 = in * 256;
        svL += mulQ14(svB, fF);
        if (svL > LIM)  svL = LIM;
        if (svL < -LIM) svL = -LIM;
        int32_t hi = in8 - svL - mulQ14(svB, qF);
        if (hi > LIM)  hi = LIM;
        if (hi < -LIM) hi = -LIM;
        svB += mulQ14(hi, fF);
        if (svB > KNEE)       svB = KNEE + ((svB - KNEE) >> 2);
        else if (svB < -KNEE) svB = -KNEE + ((svB + KNEE) >> 2);
        if (svB > LIM)  svB = LIM;
        if (svB < -LIM) svB = -LIM;

        int32_t s1o;                                    // saída do 1º estágio (Q8)
        if (fm == 0)      s1o = svL;
        else if (fm == 1) s1o = (svB * 3) >> 1;         // passa-banda x1,5
        else              s1o = hi;
        int32_t lo;
        if (slope24) {
            // 2º SVF em cascata (mesma frequência, amortecimento fixo): 24 dB/oitava
            if (s1o > LIM)  s1o = LIM;
            if (s1o < -LIM) s1o = -LIM;
            sv2L += mulQ14(sv2B, fF);
            if (sv2L > LIM)  sv2L = LIM;
            if (sv2L < -LIM) sv2L = -LIM;
            int32_t hi2 = s1o - sv2L - mulQ14(sv2B, FILTER2_Q14);
            if (hi2 > LIM)  hi2 = LIM;
            if (hi2 < -LIM) hi2 = -LIM;
            sv2B += mulQ14(hi2, fF);
            if (sv2B > KNEE)       sv2B = KNEE + ((sv2B - KNEE) >> 2);
            else if (sv2B < -KNEE) sv2B = -KNEE + ((sv2B + KNEE) >> 2);
            if (sv2B > LIM)  sv2B = LIM;
            if (sv2B < -LIM) sv2B = -LIM;
            int32_t o2;
            if (fm == 0)      o2 = sv2L;
            else if (fm == 1) o2 = (sv2B * 9) >> 3;
            else              o2 = hi2;
            lo = o2 >> 8;
        } else {
            sv2L = 0; sv2B = 0;
            lo = s1o >> 8;
        }
        if (lo > 65535)  lo = 65535;
        if (lo < -65535) lo = -65535;
        volCurQ15 += (volTargetQ15 - volCurQ15) >> 5;   // volume (knob + matriz) suavizado
        int32_t dry = (lo * (volCurQ15 >> 1)) >> 14;

        // VCA pós-filtro (zona de auto-oscilação): a senoide acompanha o envelope
        vcaQ15 += ((envMaxQ24 >> 9) - vcaQ15) >> 4;
        int32_t pg = 32768 - ((selfWetQ15 * (32768 - vcaQ15)) >> 15);
        dry = (dry * pg) >> 15;
        dry = softLimit(dry);
        lastPlayedSample = (int16_t)dry;

        if ((ctrlTick & 1) == 0) {
            uint16_t w = scopeW;
            scopeBuf[w] = (int16_t)dry;
            scopeW = (uint16_t)((w + 1) & (SCOPE_LEN - 1));
        }

#if ENABLE_FX
        int32_t outL, outR;
        fxProcess(dry, outL, outR);
        {   // medidor de saída: pico + aviso de clip (limitador trabalhando pesado)
            int32_t aL = (outL < 0) ? -outL : outL, aR = (outR < 0) ? -outR : outR;
            int32_t a = (aL > aR) ? aL : aR;
            if (a > outPeak) outPeak = a;
            if (a > 40000) outClip = true;
        }
        i2s.write16((int16_t)softLimit(outL), (int16_t)softLimit(outR));
#else
        i2s.write16((int16_t)dry, (int16_t)dry);
#endif
        produced++;
    }
    return produced;
}

// ============================================================================
// KNOBS E MIDI (com MIDI LEARN: qualquer CC pode controlar qualquer um dos 16 parâmetros)
// ============================================================================
void applyKnob(int knobIndex, int value0to127) {
    float norm = value0to127 / 127.0f;
    switch (knobIndex) {
        case 0: paramCutoff  = norm; break;
        case 1: paramReso    = norm; break;
        case 2: paramAttack  = 0.001f + norm * 2.0f; break;
        case 3: paramDecay   = 0.001f + norm * 2.0f; break;
        case 4: paramSustain = norm; break;
        case 5: paramRelease = 0.001f + norm * 3.0f; break;
        case 6: currentWave  = (Waveform)((int)(norm * ((int)WAVE_COUNT - 0.01f))); break;
        case 7: paramVolume  = norm; break;
    }
}

void syncKnobsFromParams() {
    knobValue[0] = constrain((int)(paramCutoff * 127.0f + 0.5f), 0, 127);
    knobValue[1] = constrain((int)(paramReso * 127.0f + 0.5f), 0, 127);
    knobValue[2] = constrain((int)((paramAttack  - 0.001f) / 2.0f * 127.0f + 0.5f), 0, 127);
    knobValue[3] = constrain((int)((paramDecay   - 0.001f) / 2.0f * 127.0f + 0.5f), 0, 127);
    knobValue[4] = constrain((int)(paramSustain * 127.0f + 0.5f), 0, 127);
    knobValue[5] = constrain((int)((paramRelease - 0.001f) / 3.0f * 127.0f + 0.5f), 0, 127);
    knobValue[6] = constrain((int)(((float)currentWave + 0.5f) * 127.0f / (float)WAVE_COUNT), 0, 127);
    knobValue[7] = constrain((int)(paramVolume * 127.0f + 0.5f), 0, 127);
}

const int MAP_COUNT = 16;
const char* MAP_NAMES[MAP_COUNT] = {"CUTOFF", "RESONANCE", "ATTACK", "DECAY", "SUSTAIN", "RELEASE", "WAVEFORM", "VOLUME",
                                    "DRIVE", "FILT AMT", "LFO RATE", "LFO DEPTH", "PULSE W", "SUB LEVEL", "DLY MIX", "REV MIX"};
uint8_t mapCC[MAP_COUNT] = {48, 49, 50, 51, 52, 53, 54, 55, 255, 255, 255, 255, 255, 255, 255, 255};
volatile int8_t  mapLearnIdx = -1;
volatile bool    mapDirty = false;
volatile uint8_t mapChangeCnt = 0;

void applyMapParam(int p, int v) {
    float n = v / 127.0f;
    if (p < 8) { knobValue[p] = v; applyKnob(p, v); return; }
    switch (p) {
        case 8:  paramDrive = n; break;
        case 9:  paramFiltAmt = n; break;
        case 10: paramLfoRate = 0.1f + n * 19.9f; break;
        case 11: paramLfoDepth = n; break;
        case 12: paramPwm = 0.05f + n * 0.90f; break;
        case 13: paramSubLevel = n; break;
        case 14: paramDelayMix = n; break;
        case 15: paramRevMix = n; break;
    }
}

void handleControlButton(uint8_t note, bool pressed) {
    if (!pressed) return;
    snprintf(lastMidiMsg, sizeof(lastMidiMsg), "Botao nota %u", note);
}

void onNoteOn(byte channel, byte note, byte velocity) {
    midiRxCount++;
    snprintf(lastMidiMsg, sizeof(lastMidiMsg), "Ch%u N%u v%u", channel, note, velocity);

    if (padLearnIdx >= 0) {
        if (velocity > 0) padLearnCapture(channel, note);
        return;
    }
    int pad = padFind(channel, note);
    if (pad >= 0) {
        if (velocity > 0) padPressed(pad);
        return;
    }

    if (velocity == 0) { keyOff(note); return; }
    if (note >= SYNTH_KEY_LOW && note <= SYNTH_KEY_HIGH) {
        if (seqRecArm) seqRecordNote(note, velocity);
        keyOn(note, velocity);
    } else {
        handleControlButton(note, true);
    }
}
void onNoteOff(byte channel, byte note, byte velocity) {
    midiRxCount++;
    if (padFind(channel, note) >= 0) return;
    if (note >= SYNTH_KEY_LOW && note <= SYNTH_KEY_HIGH) keyOff(note);
    else handleControlButton(note, false);
}
void onControlChange(byte channel, byte cc, byte value) {
    midiRxCount++;
    snprintf(lastMidiMsg, sizeof(lastMidiMsg), "CC %u = %u", cc, value);
    if (cc == 123 || cc == 120) {
        synthAllNotesOff();
        monoCount = 0; monoVoiceNote = -1;
        return;
    }
    if (mapLearnIdx >= 0) {
        if (cc < 120) {
            for (int j = 0; j < MAP_COUNT; j++) if (mapCC[j] == cc) mapCC[j] = 255;
            mapCC[mapLearnIdx] = cc;
            mapLearnIdx = -1;
            mapChangeCnt++;
            mapDirty = true;
        }
        return;
    }
    for (int p = 0; p < MAP_COUNT; p++) {
        if (mapCC[p] == cc) applyMapParam(p, value);
    }
}
void onProgramChange(byte channel, byte number) {
    midiRxCount++;
    snprintf(lastMidiMsg, sizeof(lastMidiMsg), "Prog %u", number);
    if (number < PRESET_COUNT) presetReq = number;
}

// ---- MIDI clock externo (24 pulsos por semínima) ----
void onClock() {
    if (!seqSyncExt || !seqRunning) return;
    if (extPulse == 0) seqStepPending = true;
    extPulse++;
    if (extPulse >= 6) extPulse = 0;
}
void onStart() {
    if (!seqSyncExt) return;
    seqPrepareStart();
    seqRunning = true;
    snprintf(lastMidiMsg, sizeof(lastMidiMsg), "MIDI Start");
}
void onContinue() {
    if (!seqSyncExt) return;
    if (!seqRunning) { extPulse = 0; seqStepPending = false; seqRunning = true; }
    snprintf(lastMidiMsg, sizeof(lastMidiMsg), "MIDI Continue");
}
void onStop() {
    if (!seqSyncExt) return;
    seqStopInternal();
    snprintf(lastMidiMsg, sizeof(lastMidiMsg), "MIDI Stop");
}

// ============================================================================
// PRESETS: 8 slots na flash (EEPROM emulada) + 8 sons de fábrica + nomes
// Mapa da EEPROM: 0..15 cabeçalho | 16..1295 slots | 1400 pads | 1500 nomes |
//                 1600 FX extras | 1800 extras (drive/glide/modos/slope) | 1900 mapa MIDI |
//                 2048 padrões A-D + chain (8 x 136) | 3200 matriz de modulação (8 x 20) |
//                 3400 FM (8 x 8) | 3500 OSC2 + unison (8 x 12) | 3700 calibração do touch |
//                 3720 wavetable (8 x 4) | 3760 LFO/accent/ring/fold (8 x 6)
// ============================================================================
const int     EE_SIZE = 4096;
const int     EE_HEADER = 16;
const int     PRESET_SLOT_BYTES = 160;
const uint8_t EE_MAGIC = 0x7B;
const uint8_t PRESET_MAGIC = 0xA6;
const int     NAME_ADDR = 1500;
const int     NAME_LEN = 12;
const uint8_t NAME_MAGIC = 0x4E;
const int     EXTRA_ADDR = 1800;
const int     EXTRA_BYTES = 12;
const uint8_t EXTRA_MAGIC = 0xE7;
const int     FXEX_ADDR = 1600;
const int     FXEX_BYTES = 8;
const uint8_t FXEX_MAGIC = 0xF1;
const int     MAP_ADDR = 1900;
const uint8_t MAP_MAGIC = 0x6D;

static_assert(sizeof(PresetData) <= PRESET_SLOT_BYTES, "PresetData maior que o slot");

void presetRedrawUI();

// fm: bits 0-1 = tipo do filtro (0 LP, 1 BP, 2 HP); bit 2 (valor 4) = 24 dB
//    nome         onda          A     D     S     R     cut   res   fAmt  fAtt  fDec  lfoR  lfoD  det   vol    dlyT   dlyFb dlyMix revS  revD  revM   pwm   pwmM  sub   pAmt  pDec  vel    drive fm vm glide
const FactoryPreset FACTORY[PRESET_COUNT] = {
    {"ROLLER",    WAVE_SAW,      0.002f,0.18f,0.35f,0.06f, 0.26f,0.38f,0.45f,0.002f,0.12f, 0.5f,0.00f,0.50f,0.85f, 363.0f,0.25f,0.00f, 0.30f,0.70f,0.05f, 0.30f,0.00f,0.45f, 0.00f,80.0f,0.30f, 0.25f,4,1,25.0f},
    {"DUB CHORD", WAVE_SAW,      0.003f,0.32f,0.00f,0.25f, 0.30f,0.25f,0.45f,0.003f,0.22f, 0.1f,0.06f,0.50f,0.75f, 363.0f,0.58f,0.35f, 0.85f,0.65f,0.35f, 0.30f,0.00f,0.00f, 0.00f,80.0f,0.40f, 0.10f,0,0,60.0f},
    {"HYPNO PLCK",WAVE_SINE,     0.001f,0.22f,0.00f,0.18f, 0.55f,0.20f,0.30f,0.001f,0.15f, 7.56f,0.12f,0.50f,0.75f, 242.0f,0.45f,0.30f, 0.60f,0.50f,0.20f, 0.30f,0.00f,0.00f, 0.00f,80.0f,0.30f, 0.00f,0,0,60.0f},
    {"RUMBLE",    WAVE_SINE,     0.001f,0.45f,0.00f,0.30f, 0.22f,0.10f,0.15f,0.001f,0.10f, 0.5f,0.00f,0.50f,0.42f, 250.0f,0.00f,0.00f, 0.90f,0.90f,0.30f, 0.30f,0.00f,0.00f, 0.45f,45.0f,0.00f, 0.10f,4,1,1.0f},
    {"BLIP",      WAVE_SQUARE,   0.001f,0.09f,0.00f,0.08f, 0.65f,0.45f,0.35f,0.001f,0.06f, 0.5f,0.00f,0.50f,0.70f, 121.0f,0.50f,0.30f, 0.50f,0.40f,0.15f, 0.40f,0.00f,0.00f, 0.08f,25.0f,0.20f, 0.00f,1,0,60.0f},
    {"DEEP PAD",  WAVE_TABLE,    0.900f,1.20f,0.80f,2.20f, 0.32f,0.15f,0.15f,0.800f,1.50f, 0.1f,0.18f,0.50f,0.65f, 363.0f,0.40f,0.18f, 0.90f,0.60f,0.50f, 0.30f,0.00f,0.00f, 0.00f,80.0f,0.00f, 0.00f,0,0,60.0f},
    {"ACID TOOL", WAVE_SAW,      0.002f,0.20f,0.20f,0.07f, 0.20f,0.68f,0.60f,0.002f,0.18f, 0.5f,0.00f,0.50f,0.80f, 363.0f,0.35f,0.15f, 0.40f,0.60f,0.08f, 0.30f,0.00f,0.00f, 0.00f,80.0f,0.35f, 0.30f,4,2,80.0f},
    {"METAL PERC",WAVE_SQUARE,   0.001f,0.06f,0.00f,0.05f, 0.70f,0.50f,0.20f,0.001f,0.05f, 0.5f,0.00f,0.50f,0.65f, 182.0f,0.30f,0.20f, 0.50f,0.30f,0.18f, 0.40f,0.00f,0.00f, 0.00f,80.0f,0.40f, 0.00f,2,0,60.0f}
};

// Extras de fábrica (o que não cabe na tabela acima): LFO, OSC2, FM, wavetable, chorus,
// bitcrusher, accent e o groove. Valem quando o slot está com o som de fábrica.
struct FactoryEx {
    uint8_t lfoShape, lfoSync, subSine;
    float accent;
    float o2Lvl, o2Semi, o2Det; uint8_t o2Wave, o2Ring, uniSel;
    float fmAmt, fmRatio, fmDec, fmEnv, fmFb;
    uint8_t wtBank; float wtPos, wtLfo;
    float choRate, choDepth, choMix, crBits, crRate, crMix;
    int bpm; float swing;
};
const FactoryEx FACTORY_EX[PRESET_COUNT] = {
    // lfo sync sub  acc    o2Lvl o2St  o2Det w ring uni  fmAmt ratio dec    env   fb    wt pos   wtLfo  choR choD choM  bits rate crush bpm swing
    {0, 0, 1, 0.35f,  0.00f, 0,    0,    0, 0, 0,   0.00f, 2.0f, 200,   0.5f, 0.0f, 0, 0.0f, 0.0f,  0.8f, 0.5f, 0.00f, 16, 1, 0.00f, 124, 0.12f},  // ROLLER
    {1, 1, 0, 0.30f,  0.60f, 7,    6,    0, 0, 1,   0.00f, 2.0f, 200,   0.5f, 0.0f, 0, 0.0f, 0.0f,  0.5f, 0.6f, 0.30f, 16, 1, 0.00f, 122, 0.10f},  // DUB CHORD
    {0, 1, 0, 0.30f,  0.00f, 0,    0,    0, 0, 0,   0.38f, 3.5f, 120,   0.9f, 0.1f, 0, 0.0f, 0.0f,  0.8f, 0.5f, 0.00f, 16, 1, 0.00f, 124, 0.15f},  // HYPNO PLCK
    {0, 0, 0, 0.20f,  0.00f, 0,    0,    0, 0, 0,   0.00f, 2.0f, 200,   0.5f, 0.0f, 0, 0.0f, 0.0f,  0.8f, 0.5f, 0.00f, 16, 1, 0.00f, 124, 0.00f},  // RUMBLE
    {0, 0, 0, 0.30f,  0.00f, 0,    0,    0, 0, 0,   0.00f, 2.0f, 200,   0.5f, 0.0f, 0, 0.0f, 0.0f,  0.8f, 0.5f, 0.00f, 10, 2, 0.35f, 125, 0.10f},  // BLIP
    {1, 1, 0, 0.30f,  0.40f, 7,    8,    2, 0, 0,   0.00f, 2.0f, 200,   0.5f, 0.0f, 1, 0.3f, 0.35f, 0.4f, 0.6f, 0.45f, 16, 1, 0.00f, 120, 0.00f},  // DEEP PAD
    {0, 0, 0, 0.65f,  0.00f, 0,    0,    0, 0, 0,   0.00f, 2.0f, 200,   0.5f, 0.0f, 0, 0.0f, 0.0f,  0.8f, 0.5f, 0.00f, 16, 1, 0.00f, 124, 0.08f},  // ACID TOOL
    {0, 0, 0, 0.30f,  0.80f, 19,   0,    1, 1, 0,   0.00f, 2.0f, 200,   0.5f, 0.0f, 0, 0.0f, 0.0f,  0.8f, 0.5f, 0.00f, 12, 1, 0.20f, 126, 0.15f},  // METAL PERC
};

// Groove de cada preset (padrão A), tom de Sol menor. "G0" = Sol da oitava -1 (G1), "G1" = G2...
// Depois da nota: A = accent, S = slide, p/h/q = probabilidade 75/50/25 %, r = ratchet x2.
// Os padrões de fábrica não usam probabilidade: todo passo com nota toca sempre.
const char* const FACTORY_PAT[PRESET_COUNT][16] = {
    {"--","G0","G0A","G0",  "--","G0","G0","A#0", "--","G0","G0A","G0", "--","F0","G0","G1S"},      // ROLLER
    {"--","--","G1A","--",  "--","--","--","--",  "--","--","G1","--",   "--","F1","--","--"},      // DUB CHORD
    {"G1","--","D2","A#1",  "--","G2","D2","--", "G1","--","F2","A#1",  "D2","--","G1","C2"},     // HYPNO PLCK
    {"G0A","--","--","--",  "G0","--","--","--",  "G0A","--","--","--",   "G0","--","--","G0"},     // RUMBLE
    {"--","--","G2","--",   "--","D3","--","--", "--","G2","--","A#2",  "--","--","F2","--"},     // BLIP
    {"G1","--","--","--",   "--","--","--","--",  "D#1","--","--","--",   "--","--","--","--"},      // DEEP PAD
    {"G0A","G0","G1S","G0", "A#0","G0A","--","G0","C1S","D1","G0A","--",  "F0","G0","G1AS","G0"},   // ACID TOOL
    {"--","--","G3","--",   "--","--","G3A","--", "--","--","G3","G3",   "--","--","G3Ar","--"},    // METAL PERC
};


static float clampF(float v, float lo, float hi) {
    if (!(v >= lo)) return lo;
    if (v > hi) return hi;
    return v;
}

// ---- nomes personalizados dos slots ----
char slotName[PRESET_COUNT][NAME_LEN];
bool slotHasName[PRESET_COUNT];

void nameSaveAll() {
    EEPROM.write(NAME_ADDR, NAME_MAGIC);
    for (int i = 0; i < PRESET_COUNT; i++) {
        for (int j = 0; j < NAME_LEN; j++) {
            EEPROM.write(NAME_ADDR + 1 + i * NAME_LEN + j, slotHasName[i] ? (uint8_t)slotName[i][j] : 0);
        }
    }
    EEPROM.commit();
}

void nameLoadAll() {
    for (int i = 0; i < PRESET_COUNT; i++) { slotHasName[i] = false; slotName[i][0] = 0; }
    if (EEPROM.read(NAME_ADDR) != NAME_MAGIC) return;
    for (int i = 0; i < PRESET_COUNT; i++) {
        for (int j = 0; j < NAME_LEN; j++) slotName[i][j] = (char)EEPROM.read(NAME_ADDR + 1 + i * NAME_LEN + j);
        slotName[i][NAME_LEN - 1] = 0;
        for (int j = 0; slotName[i][j]; j++) {
            char c = slotName[i][j];
            bool ok = (c == ' ') || (c >= 'A' && c <= 'Z') || (c >= '0' && c <= '9');
            if (!ok) slotName[i][j] = '?';
        }
        slotHasName[i] = (slotName[i][0] != 0);
    }
}

// ---- parâmetros extras de cada slot (drive, glide, filtro, voz) ----
void extraWrite(int slot) {
    int a = EXTRA_ADDR + slot * EXTRA_BYTES;
    float drive = paramDrive, glide = paramGlideMs;
    EEPROM.write(a, EXTRA_MAGIC);
    EEPROM.put(a + 1, drive);
    EEPROM.put(a + 5, glide);
    EEPROM.write(a + 9, (uint8_t)((filtMode & 3) | ((voiceMode & 3) << 2) | ((filtSlope & 1) << 4)));
}

bool extraRead(int slot, float &drive, float &glide, uint8_t &modes) {
    int a = EXTRA_ADDR + slot * EXTRA_BYTES;
    if (EEPROM.read(a) != EXTRA_MAGIC) return false;
    EEPROM.get(a + 1, drive);
    EEPROM.get(a + 5, glide);
    modes = EEPROM.read(a + 9);
    return true;
}

void extraInvalidate(int slot) { EEPROM.write(EXTRA_ADDR + slot * EXTRA_BYTES, 0); }

void presetApplyExtra(float drive, float glide, uint8_t modes) {
    paramDrive = clampF(drive, 0.0f, 1.0f);
    paramGlideMs = clampF(glide, 1.0f, 500.0f);
    uint8_t fmd = modes & 3;
    if (fmd > 2) fmd = 0;
    filtMode = fmd;
    filtSlope = (modes >> 4) & 1;
    uint8_t vm = (modes >> 2) & 3;
    if (vm > 2) vm = 0;
    if (vm != voiceMode) { voiceMode = vm; monoResetReq = true; }
}

// ---- FX extras de cada slot (chorus e bitcrusher), 1 byte por parâmetro ----
void fxExtraWrite(int slot) {
    int a = FXEX_ADDR + slot * FXEX_BYTES;
    EEPROM.write(a, FXEX_MAGIC);
    EEPROM.write(a + 1, (uint8_t)constrain((int)((paramChoRate - 0.1f) / 4.9f * 255.0f + 0.5f), 0, 255));
    EEPROM.write(a + 2, (uint8_t)constrain((int)(paramChoDepth * 255.0f + 0.5f), 0, 255));
    EEPROM.write(a + 3, (uint8_t)constrain((int)(paramChoMix * 255.0f + 0.5f), 0, 255));
    EEPROM.write(a + 4, (uint8_t)constrain((int)(paramCrBits + 0.5f), 4, 16));
    EEPROM.write(a + 5, (uint8_t)constrain((int)(paramCrRate + 0.5f), 1, 24));
    EEPROM.write(a + 6, (uint8_t)constrain((int)(paramCrMix * 255.0f + 0.5f), 0, 255));
}

void fxExtraInvalidate(int slot) { EEPROM.write(FXEX_ADDR + slot * FXEX_BYTES, 0); }

void fxExtraLoad(int slot, bool user) {
    int a = FXEX_ADDR + slot * FXEX_BYTES;
    if (user && EEPROM.read(a) == FXEX_MAGIC) {
        paramChoRate  = 0.1f + (EEPROM.read(a + 1) / 255.0f) * 4.9f;
        paramChoDepth = EEPROM.read(a + 2) / 255.0f;
        paramChoMix   = EEPROM.read(a + 3) / 255.0f;
        paramCrBits   = clampF((float)EEPROM.read(a + 4), 4.0f, 16.0f);
        paramCrRate   = clampF((float)EEPROM.read(a + 5), 1.0f, 24.0f);
        paramCrMix    = EEPROM.read(a + 6) / 255.0f;
        return;
    }
    paramChoRate = 0.8f; paramChoDepth = 0.5f; paramChoMix = 0.0f;
    paramCrBits = 16.0f; paramCrRate = 1.0f;  paramCrMix = 0.0f;
    if (!user) {
    }
}

int presetSlotAddr(int i) { return EE_HEADER + i * PRESET_SLOT_BYTES; }

const char* presetName(int i) {
    if (slotHasName[i]) return slotName[i];
    return slotIsUser[i] ? "USER PATCH" : FACTORY[i].name;
}

static uint16_t presetCrc(PresetData &d) {
    uint16_t saved = d.crc;
    d.crc = 0;
    const uint8_t *p = (const uint8_t*)&d;
    uint16_t c = 0xFFFF;
    for (size_t i = 0; i < sizeof(PresetData); i++) {
        c ^= p[i];
        c = (uint16_t)((c << 5) | (c >> 11));
        c = (uint16_t)(c + 0x1D3);
    }
    d.crc = saved;
    return c;
}

bool presetReadSlot(int i, PresetData &d) {
    EEPROM.get(presetSlotAddr(i), d);
    if (d.magic != PRESET_MAGIC) return false;
    return d.crc == presetCrc(d);
}

void presetCapture(PresetData &d) {
    memset(&d, 0, sizeof(d));
    d.magic = PRESET_MAGIC;
    d.wave = (uint8_t)currentWave;
    d.hasPattern = (uint8_t)(1 | ((seqMode & 3) << 4));
    d.reserved = subMode;
    d.bpm = (uint16_t)seqBpm;
    d.attack = paramAttack;   d.decay = paramDecay;   d.sustain = paramSustain; d.release = paramRelease;
    d.cutoff = paramCutoff;   d.reso = paramReso;     d.filtAmt = paramFiltAmt;
    d.filtAtt = paramFiltAtt; d.filtDec = paramFiltDec;
    d.lfoRate = paramLfoRate; d.lfoDepth = paramLfoDepth; d.detune = paramDetune; d.volume = paramVolume;
    d.dlyTime = paramDelayTime; d.dlyFb = paramDelayFb; d.dlyMix = paramDelayMix;
    d.revSize = paramRevSize;   d.revDamp = paramRevDamp; d.revMix = paramRevMix;
    d.pwm = paramPwm; d.pwmMod = paramPwmMod; d.subLevel = paramSubLevel;
    d.pitchAmt = paramPitchAmt; d.pitchDec = paramPitchDecMs; d.velFilt = paramVelFilt; d.swing = paramSwing;
    for (int i = 0; i < SEQ_STEPS; i++) {     // padrão A (os demais vão no registro "bank")
        d.semi[i] = seqBank[0][i].semi;
        d.oct[i]  = seqBank[0][i].oct;
        d.flags[i] = (seqBank[0][i].gate ? 1 : 0) | (seqBank[0][i].accent ? 2 : 0) | (seqBank[0][i].slide ? 4 : 0);
    }
}

void presetFromFactory(int i, PresetData &d) {
    const FactoryPreset &f = FACTORY[i];
    memset(&d, 0, sizeof(d));
    d.magic = PRESET_MAGIC;
    d.wave = f.wave;
    d.hasPattern = 0;
    d.reserved = 0;
    d.attack = f.a; d.decay = f.d; d.sustain = f.s; d.release = f.r;
    d.cutoff = f.cut; d.reso = f.res; d.filtAmt = f.fAmt; d.filtAtt = f.fAtt; d.filtDec = f.fDec;
    d.lfoRate = f.lfoR; d.lfoDepth = f.lfoD; d.detune = f.det; d.volume = f.vol;
    d.dlyTime = f.dT; d.dlyFb = f.dF; d.dlyMix = f.dM;
    d.revSize = f.rS; d.revDamp = f.rD; d.revMix = f.rM;
    d.pwm = f.pwm; d.pwmMod = f.pwmMod; d.subLevel = f.sub;
    d.pitchAmt = f.pAmt; d.pitchDec = f.pDecMs; d.velFilt = f.vel; d.swing = 0.0f;
}

void presetApply(const PresetData &d) {
    int w = d.wave;
    if (w < 0) w = 0;
    if (w >= (int)WAVE_COUNT) w = (int)WAVE_COUNT - 1;
    currentWave = (Waveform)w;

    paramAttack  = clampF(d.attack,  0.001f, 2.0f);
    paramDecay   = clampF(d.decay,   0.001f, 2.0f);
    paramSustain = clampF(d.sustain, 0.0f,   1.0f);
    paramRelease = clampF(d.release, 0.001f, 3.0f);
    paramCutoff  = clampF(d.cutoff,  0.05f,  1.0f);
    paramReso    = clampF(d.reso,    0.0f,   1.0f);
    paramFiltAmt = clampF(d.filtAmt, 0.0f,   1.0f);
    paramFiltAtt = clampF(d.filtAtt, 0.001f, 3.0f);
    paramFiltDec = clampF(d.filtDec, 0.001f, 3.0f);
    paramLfoRate = clampF(d.lfoRate, 0.1f,   20.0f);
    paramLfoDepth = clampF(d.lfoDepth, 0.0f, 1.0f);
    paramDetune  = clampF(d.detune,  0.0f,   1.0f);
    paramVolume  = clampF(d.volume,  0.0f,   1.0f);
    paramDelayTime = clampF(d.dlyTime, 40.0f, 500.0f);
    paramDelayFb   = clampF(d.dlyFb,   0.0f,  0.90f);
    paramDelayMix  = clampF(d.dlyMix,  0.0f,  1.0f);
    paramRevSize   = clampF(d.revSize, 0.0f,  1.0f);
    paramRevDamp   = clampF(d.revDamp, 0.0f,  1.0f);
    paramRevMix    = clampF(d.revMix,  0.0f,  1.0f);
    paramPwm       = clampF(d.pwm,     0.05f, 0.95f);
    paramPwmMod    = clampF(d.pwmMod,  0.0f,  1.0f);
    paramSubLevel  = clampF(d.subLevel, 0.0f, 1.0f);
    paramPitchAmt  = clampF(d.pitchAmt, 0.0f, 1.0f);
    paramPitchDecMs = clampF(d.pitchDec, 5.0f, 800.0f);
    paramVelFilt   = clampF(d.velFilt, 0.0f,  1.0f);
    subMode = d.reserved ? 1 : 0;

    if ((d.hasPattern & 1) && presetLoadPattern) {
        for (int i = 0; i < SEQ_STEPS; i++) {
            int semi = d.semi[i]; if (semi > 12) semi = 12;
            int oct = d.oct[i];   if (oct < -1) oct = -1; if (oct > 2) oct = 2;
            seqBank[0][i].semi = (uint8_t)semi;
            seqBank[0][i].oct = (int8_t)oct;
            seqBank[0][i].gate   = (d.flags[i] & 1) != 0;
            seqBank[0][i].accent = (d.flags[i] & 2) != 0;
            seqBank[0][i].slide  = (d.flags[i] & 4) != 0;
            seqBank[0][i].probIdx = 0;
            seqBank[0][i].ratchIdx = 0;
        }
        seqBpm = constrain((int)d.bpm, 40, 300);
        seqMode = (uint8_t)((d.hasPattern >> 4) & 3);
        paramSwing = clampF(d.swing, 0.0f, 1.0f);
        seqUpdateTiming();
    }
    syncKnobsFromParams();
}

// ---- padrões A-D + chain de cada slot (2 bytes por passo) ----
const int     BANK_ADDR = 2048;
const int     BANK_BYTES = 136;
const uint8_t BANK_MAGIC = 0xB4;
const int     MM_ADDR = 3200;
const int     MM_BYTES = 20;
const uint8_t MM_MAGIC = 0xA7;

void bankWrite(int slot) {
    int a = BANK_ADDR + slot * BANK_BYTES;
    EEPROM.write(a, BANK_MAGIC);
    uint8_t len = seqChainLen;
    EEPROM.write(a + 1, (uint8_t)((seqChainOn ? 0x80 : 0) | (len & 15)));
    for (int h = 0; h < 2; h++) {
        uint8_t c = 0;
        for (int k = 0; k < 4; k++) c |= (uint8_t)((seqChain[h * 4 + k] & 3) << (k * 2));
        EEPROM.write(a + 2 + h, c);
    }
    int p = a + 4;
    for (int pat = 0; pat < PATTERN_COUNT; pat++) {
        for (int i = 0; i < SEQ_STEPS; i++) {
            const SeqStep &s = seqBank[pat][i];
            uint8_t b0 = (uint8_t)((s.semi & 15) | (((s.oct + 1) & 3) << 4) | (s.gate ? 0x40 : 0) | (s.accent ? 0x80 : 0));
            uint8_t b1 = (uint8_t)((s.slide ? 1 : 0) | ((s.probIdx & 3) << 1) | ((s.ratchIdx & 3) << 3));
            EEPROM.write(p++, b0);
            EEPROM.write(p++, b1);
        }
    }
}

bool bankRead(int slot) {
    int a = BANK_ADDR + slot * BANK_BYTES;
    if (EEPROM.read(a) != BANK_MAGIC) return false;
    uint8_t h = EEPROM.read(a + 1);
    uint8_t len = h & 15;
    seqChainLen = (len < 1) ? 1 : ((len > 8) ? 8 : len);
    seqChainOn = (h & 0x80) != 0;
    for (int hh = 0; hh < 2; hh++) {
        uint8_t c = EEPROM.read(a + 2 + hh);
        for (int k = 0; k < 4; k++) seqChain[hh * 4 + k] = (c >> (k * 2)) & 3;
    }
    int p = a + 4;
    for (int pat = 0; pat < PATTERN_COUNT; pat++) {
        for (int i = 0; i < SEQ_STEPS; i++) {
            uint8_t b0 = EEPROM.read(p++);
            uint8_t b1 = EEPROM.read(p++);
            SeqStep &s = seqBank[pat][i];
            int semi = b0 & 15; if (semi > 12) semi = 12;
            s.semi = (uint8_t)semi;
            s.oct = (int8_t)(((b0 >> 4) & 3) - 1);
            s.gate = (b0 & 0x40) != 0;
            s.accent = (b0 & 0x80) != 0;
            s.slide = (b1 & 1) != 0;
            s.probIdx = (b1 >> 1) & 3;
            s.ratchIdx = (b1 >> 3) & 3;
        }
    }
    return true;
}

void bankInvalidate(int slot) { EEPROM.write(BANK_ADDR + slot * BANK_BYTES, 0); }

// ---- matriz de modulação de cada slot (1 byte com sinal por célula) ----
void mmWrite(int slot) {
    int a = MM_ADDR + slot * MM_BYTES;
    EEPROM.write(a, MM_MAGIC);
    for (int i = 0; i < 16; i++) {
        int v = (int)(clampF(mmAmt[i], -1.0f, 1.0f) * 127.0f + ((mmAmt[i] >= 0.0f) ? 0.5f : -0.5f));
        EEPROM.write(a + 1 + i, (uint8_t)(int8_t)v);
    }
}

void mmRead(int slot, bool user) {
    int a = MM_ADDR + slot * MM_BYTES;
    if (user && EEPROM.read(a) == MM_MAGIC) {
        for (int i = 0; i < 16; i++) mmAmt[i] = clampF((float)(int8_t)EEPROM.read(a + 1 + i) / 127.0f, -1.0f, 1.0f);
    } else {
        for (int i = 0; i < 16; i++) mmAmt[i] = 0.0f;
    }
}

void mmInvalidate(int slot) { EEPROM.write(MM_ADDR + slot * MM_BYTES, 0); }

// ---- FM de cada slot (1 byte por parâmetro) ----
const int     FM_ADDR = 3400;
const int     FM_BYTES = 8;
const uint8_t FM_MAGIC = 0xF4;

void fmWrite(int slot) {
    int a = FM_ADDR + slot * FM_BYTES;
    EEPROM.write(a, FM_MAGIC);
    EEPROM.write(a + 1, (uint8_t)constrain((int)(paramFmAmt * 255.0f + 0.5f), 0, 255));
    EEPROM.write(a + 2, (uint8_t)constrain((int)(paramFmRatio * 16.0f + 0.5f), 4, 192));
    EEPROM.write(a + 3, (uint8_t)constrain((int)(sqrtf(paramFmDecMs) * 5.0f + 0.5f), 0, 255));
    EEPROM.write(a + 4, (uint8_t)constrain((int)(paramFmEnv * 255.0f + 0.5f), 0, 255));
    EEPROM.write(a + 5, (uint8_t)constrain((int)(paramFmFb * 255.0f + 0.5f), 0, 255));
    EEPROM.write(a + 6, fmSnap ? 1 : 0);
}

void fmRead(int slot, bool user) {
    int a = FM_ADDR + slot * FM_BYTES;
    if (user && EEPROM.read(a) == FM_MAGIC) {
        paramFmAmt   = EEPROM.read(a + 1) / 255.0f;
        paramFmRatio = clampF(EEPROM.read(a + 2) / 16.0f, 0.5f, 12.0f);
        float d = EEPROM.read(a + 3) / 5.0f;
        paramFmDecMs = clampF(d * d, 5.0f, 2000.0f);
        paramFmEnv   = EEPROM.read(a + 4) / 255.0f;
        paramFmFb    = EEPROM.read(a + 5) / 255.0f;
        fmSnap       = (EEPROM.read(a + 6) != 0);
    } else {
        paramFmAmt = 0.0f; paramFmRatio = 2.0f; paramFmDecMs = 200.0f;
        paramFmEnv = 0.5f; paramFmFb = 0.0f; fmSnap = true;
    }
}

void fmInvalidate(int slot) { EEPROM.write(FM_ADDR + slot * FM_BYTES, 0); }

// ---- OSC2 + UNISON de cada slot ----
const int     O2_ADDR = 3500;
const int     O2_BYTES = 12;
const uint8_t O2_MAGIC = 0xD2;

void o2Write(int slot) {
    int a = O2_ADDR + slot * O2_BYTES;
    EEPROM.write(a, O2_MAGIC);
    EEPROM.write(a + 1, (uint8_t)constrain((int)(paramO2Lvl * 255.0f + 0.5f), 0, 255));
    EEPROM.write(a + 2, (uint8_t)constrain((int)(paramO2Semi + 24.5f), 0, 48));
    EEPROM.write(a + 3, (uint8_t)constrain((int)(paramO2Det + 100.5f), 0, 200));
    EEPROM.write(a + 4, (uint8_t)((o2Wave & 3) | (o2Sync ? 8 : 0) | ((uniSel & 3) << 4)));
    EEPROM.write(a + 5, (uint8_t)constrain((int)(paramUniDet * 255.0f + 0.5f), 0, 255));
}

void o2Read(int slot, bool user) {
    int a = O2_ADDR + slot * O2_BYTES;
    if (user && EEPROM.read(a) == O2_MAGIC) {
        paramO2Lvl  = EEPROM.read(a + 1) / 255.0f;
        paramO2Semi = (float)((int)EEPROM.read(a + 2) - 24);
        paramO2Det  = (float)((int)EEPROM.read(a + 3) - 100);
        uint8_t m = EEPROM.read(a + 4);
        o2Wave = m & 3; o2Sync = (m & 8) != 0; uniSel = (m >> 4) & 3;
        paramUniDet = EEPROM.read(a + 5) / 255.0f;
    } else {
        paramO2Lvl = 0.0f; paramO2Semi = 0.0f; paramO2Det = 0.0f;
        o2Wave = 0; o2Sync = false; uniSel = 0; paramUniDet = 0.4f;
    }
}

void o2Invalidate(int slot) { EEPROM.write(O2_ADDR + slot * O2_BYTES, 0); }

// ---- WAVETABLE de cada slot (banco, posição, LFO) ----
const int     WT_ADDR = 3720;
const int     WT_BYTES = 4;
const uint8_t WT_MAGIC = 0x57;

void wtWrite(int slot) {
    int a = WT_ADDR + slot * WT_BYTES;
    EEPROM.write(a, WT_MAGIC);
    EEPROM.write(a + 1, (uint8_t)(wtBank & 3));
    EEPROM.write(a + 2, (uint8_t)constrain((int)(paramWtPos * 255.0f + 0.5f), 0, 255));
    EEPROM.write(a + 3, (uint8_t)constrain((int)(paramWtLfo * 255.0f + 0.5f), 0, 255));
}

void wtRead(int slot, bool user) {
    int a = WT_ADDR + slot * WT_BYTES;
    if (user && EEPROM.read(a) == WT_MAGIC) {
        wtBank     = EEPROM.read(a + 1) & 3;
        paramWtPos = EEPROM.read(a + 2) / 255.0f;
        paramWtLfo = EEPROM.read(a + 3) / 255.0f;
    } else {
        wtBank = 0; paramWtPos = 0.0f; paramWtLfo = 0.0f;
    }
}

void wtInvalidate(int slot) { EEPROM.write(WT_ADDR + slot * WT_BYTES, 0); }

// ---- LFO (forma/sync), accent, ring mod e wavefolder de cada slot ----
const int     NX_ADDR = 3760;
const int     NX_BYTES = 6;
const uint8_t NX_MAGIC = 0x6E;

void nxWrite(int slot) {
    int a = NX_ADDR + slot * NX_BYTES;
    EEPROM.write(a, NX_MAGIC);
    EEPROM.write(a + 1, (uint8_t)((lfoShape % 5) | (lfoSync ? 8 : 0) | (o2Ring ? 16 : 0)));
    EEPROM.write(a + 2, (uint8_t)constrain((int)(paramAccent * 255.0f + 0.5f), 0, 255));
    EEPROM.write(a + 3, (uint8_t)constrain((int)(paramFold * 255.0f + 0.5f), 0, 255));
}

void nxRead(int slot, bool user) {
    int a = NX_ADDR + slot * NX_BYTES;
    if (user && EEPROM.read(a) == NX_MAGIC) {
        uint8_t m = EEPROM.read(a + 1);
        lfoShape = (m & 7) % 5; lfoSync = (m & 8) != 0; o2Ring = (m & 16) != 0;
        paramAccent = EEPROM.read(a + 2) / 255.0f;
        paramFold   = EEPROM.read(a + 3) / 255.0f;
    } else {
        lfoShape = 0; lfoSync = false; o2Ring = false; paramAccent = 0.4f; paramFold = 0.0f;
    }
}

void nxInvalidate(int slot) { EEPROM.write(NX_ADDR + slot * NX_BYTES, 0); }

// aplica os extras e o groove do preset de fábrica i
void factoryExtraApply(int i, bool withPattern) {
    const FactoryEx &e = FACTORY_EX[i];
    lfoShape = e.lfoShape % 5; lfoSync = e.lfoSync != 0; subMode = e.subSine ? 1 : 0;
    paramAccent = e.accent;
    paramO2Lvl = e.o2Lvl; paramO2Semi = e.o2Semi; paramO2Det = e.o2Det;
    o2Wave = e.o2Wave & 3; o2Ring = e.o2Ring != 0; o2Sync = false;
    uniSel = e.uniSel & 3;
    paramFmAmt = e.fmAmt; paramFmRatio = e.fmRatio; paramFmDecMs = e.fmDec; paramFmEnv = e.fmEnv; paramFmFb = e.fmFb;
    wtBank = e.wtBank & 3; paramWtPos = e.wtPos; paramWtLfo = e.wtLfo;
    paramChoRate = e.choRate; paramChoDepth = e.choDepth; paramChoMix = e.choMix;
    paramCrBits = e.crBits; paramCrRate = e.crRate; paramCrMix = e.crMix;
    if (!withPattern) return;

    for (int k = 0; k < SEQ_STEPS; k++) {
        const char *t = FACTORY_PAT[i][k];
        SeqStep &st = seqBank[0][k];
        st.gate = false; st.accent = false; st.slide = false; st.probIdx = 0; st.ratchIdx = 0;
        if (t[0] == '-') continue;
        static const int8_t NOTE[7] = {9, 11, 0, 2, 4, 5, 7};    // A B C D E F G
        int semi = NOTE[(t[0] - 'A') % 7];
        int j = 1;
        if (t[j] == '#') { semi++; j++; }
        int oct = (t[j] - '0') - 1; j++;
        if (semi >= 12) { semi -= 12; oct++; }
        st.semi = (uint8_t)semi; st.oct = (int8_t)constrain(oct, -1, 2); st.gate = true;
        for (; t[j]; j++) {
            if (t[j] == 'A') st.accent = true;
            if (t[j] == 'S') st.slide = true;
            if (t[j] == 'p') st.probIdx = 1;
            if (t[j] == 'h') st.probIdx = 2;
            if (t[j] == 'q') st.probIdx = 3;
            if (t[j] == 'r') st.ratchIdx = 1;
        }
    }
    seqBpm = constrain(e.bpm, 40, 300);
    seqMode = 0;
    paramSwing = e.swing;
    seqUpdateTiming();
    seqRedrawMask = 0xFFFF;
    seqEditorDirty = true;
}

void presetLoadCore(int i) {
    if (i < 0 || i >= PRESET_COUNT) return;
    PresetData d;
    float drive = 0.0f, glide = 60.0f;
    uint8_t modes = 0;
    bool ok = slotIsUser[i] && presetReadSlot(i, d);
    if (ok) {
        if (!extraRead(i, drive, glide, modes)) { drive = 0.0f; glide = 60.0f; modes = 0; }
    } else {
        slotIsUser[i] = false;
        presetFromFactory(i, d);
        const FactoryPreset &f = FACTORY[i];
        drive = f.drive; glide = f.glide;
        modes = (uint8_t)((f.fmode & 3) | ((f.vmode & 3) << 2) | ((f.fmode & 4) ? 16 : 0));
    }
    presetApply(d);
    if (ok && presetLoadPattern) bankRead(i);
    mmRead(i, ok);
    fmRead(i, ok);
    o2Read(i, ok);
    wtRead(i, ok);
    nxRead(i, ok);
    presetApplyExtra(drive, glide, modes);
    fxExtraLoad(i, ok);
    if (!ok) factoryExtraApply(i, presetLoadPattern);
    presetCur = i;
    snprintf(presetMsg, sizeof(presetMsg), "Loaded: %s", presetName(i));
}

static void presetWriteHeader(int lastSlot) {
    EEPROM.write(0, EE_MAGIC);
    EEPROM.write(1, (uint8_t)lastSlot);
    EEPROM.write(2, presetLoadPattern ? 1 : 0);
    EEPROM.write(3, seqSyncExt ? 1 : 0);
}

void presetSaveSlot(int i) {
    snprintf(presetMsg, sizeof(presetMsg), "Saving...");
    presetRedrawUI();

    PresetData d;
    presetCapture(d);
    d.crc = presetCrc(d);
    EEPROM.put(presetSlotAddr(i), d);
    extraWrite(i);
    fxExtraWrite(i);
    bankWrite(i);
    mmWrite(i);
    fmWrite(i);
    o2Write(i);
    wtWrite(i);
    nxWrite(i);
    presetWriteHeader(i);
    bool ok = EEPROM.commit();

    if (ok) {
        slotIsUser[i] = true;
        presetCur = i;
        snprintf(presetMsg, sizeof(presetMsg), "Saved to slot %d", i + 1);
    } else {
        snprintf(presetMsg, sizeof(presetMsg), "Save failed!");
    }
    presetRedrawUI();
}

void presetFactorySlot(int i) {
    snprintf(presetMsg, sizeof(presetMsg), "Restoring...");
    presetRedrawUI();

    EEPROM.write(presetSlotAddr(i), 0);
    extraInvalidate(i);
    fxExtraInvalidate(i);
    bankInvalidate(i);
    mmInvalidate(i);
    fmInvalidate(i);
    o2Invalidate(i);
    wtInvalidate(i);
    nxInvalidate(i);
    presetWriteHeader(0);
    EEPROM.commit();
    slotIsUser[i] = false;
    slotHasName[i] = false;
    nameSaveAll();
    presetLoadCore(i);
    snprintf(presetMsg, sizeof(presetMsg), "Slot %d = factory", i + 1);
    presetRedrawUI();
}

void padSaveMap() {
    EEPROM.write(PAD_MAP_ADDR, PAD_MAGIC);
    for (int i = 0; i < PAD_COUNT; i++) {
        EEPROM.write(PAD_MAP_ADDR + 1 + i, padCh[i]);
        EEPROM.write(PAD_MAP_ADDR + 1 + PAD_COUNT + i, padNote[i]);
    }
    EEPROM.commit();
}

void padLoadMap() {
    if (EEPROM.read(PAD_MAP_ADDR) != PAD_MAGIC) return;
    for (int i = 0; i < PAD_COUNT; i++) {
        uint8_t c = EEPROM.read(PAD_MAP_ADDR + 1 + i);
        uint8_t n = EEPROM.read(PAD_MAP_ADDR + 1 + PAD_COUNT + i);
        if (c >= 1 && c <= 16 && n < 128) { padCh[i] = c; padNote[i] = n; }
        else                              { padCh[i] = 0; }
    }
}

void mapSave() {
    EEPROM.write(MAP_ADDR, MAP_MAGIC);
    for (int i = 0; i < MAP_COUNT; i++) EEPROM.write(MAP_ADDR + 1 + i, mapCC[i]);
    EEPROM.commit();
}

void mapLoad() {
    if (EEPROM.read(MAP_ADDR) != MAP_MAGIC) return;
    for (int i = 0; i < MAP_COUNT; i++) {
        uint8_t c = EEPROM.read(MAP_ADDR + 1 + i);
        mapCC[i] = (c < 120) ? c : 255;
    }
}

void presetBoot() {
    EEPROM.begin(EE_SIZE);
    seqInitBanks();
    PresetData tmp;
    for (int i = 0; i < PRESET_COUNT; i++) slotIsUser[i] = presetReadSlot(i, tmp);
    nameLoadAll();

    int last = 0;
    if (EEPROM.read(0) == EE_MAGIC) {
        last = EEPROM.read(1);
        if (last >= PRESET_COUNT) last = 0;
        presetLoadPattern = (EEPROM.read(2) != 0);
        seqSyncExt = (EEPROM.read(3) == 1);
    }
    presetLoadCore(last);
    padLoadMap();
    mapLoad();
}

// ============================================================================
// PUBLICAÇÃO DOS PARÂMETROS (roda no core da tela, a cada ~4 ms)
// Converte os floats em inteiros de ponto fixo; o core de áudio só lê esses inteiros.
// ============================================================================
void publishParams() {
    updateEnvCoefs();
    fxUpdateParams();

    pCutBaseQ15  = (int32_t)(clampF(paramCutoff, 0.0f, 1.0f) * 32768.0f);
    pLfoHalfQ15  = (int32_t)(clampF(paramLfoDepth, 0.0f, 1.0f) * 16384.0f);      // profundidade x 0,5
    pFiltAmtQ15  = (int32_t)(clampF(paramFiltAmt, 0.0f, 1.0f) * 32768.0f);
    pVelFiltQ15  = (int32_t)(clampF(paramVelFilt, 0.0f, 1.0f) * 32768.0f);
    pQTargetQ14  = (int32_t)((1.0f - clampF(paramReso, 0.0f, 1.0f) * 1.06f) * 16384.0f);
    if (lfoSync) {                // divisão do BPM: Hz = BPM / (240 x notas inteiras por ciclo)
        float hz = (float)seqBpm / (240.0f * LFO_SYNC_WHOLE[lfoSyncIdx()]);
        pLfoInc32 = (uint32_t)(hz * 134217.728f);
    } else {
        pLfoInc32 = (uint32_t)(clampF(paramLfoRate, 0.1f, 20.0f) * 134217.728f);
    }
    pAccentQ15   = (int32_t)(clampF(paramAccent, 0.0f, 1.0f) * 32768.0f);
    pFoldOn      = (paramFold > 0.01f);
    pFoldGainQ8  = (int32_t)((1.0f + clampF(paramFold, 0.0f, 1.0f) * 7.0f) * 256.0f);
    pPwmBaseQ16  = (int32_t)(clampF(paramPwm, 0.05f, 0.95f) * 65536.0f);
    pPwmModQ16   = (int32_t)(clampF(paramPwmMod, 0.0f, 1.0f) * 0.4f * 65536.0f);

    pDriveOn      = (paramDrive > 0.01f);
    pDriveGainQ8  = (int32_t)((1.0f + clampF(paramDrive, 0.0f, 1.0f) * 7.0f) * 256.0f);
    pDriveCompQ15 = (int32_t)(32768.0f / (1.0f + clampF(paramDrive, 0.0f, 1.0f) * 1.5f));

    float wet = clampF((paramReso - 0.88f) * 8.33f, 0.0f, 1.0f);
    pSelfWetQ15  = (int32_t)(wet * 32768.0f);
    pSeedOn      = (paramReso > 0.93f);

    pSpreadQ16   = (int32_t)((0.006f + clampF(paramDetune, 0.0f, 1.0f) * 0.02f) * 65536.0f);

    float sl = clampF(paramSubLevel, 0.0f, 1.0f);
    pSubGainQ15  = (int32_t)(sl * 0.70f * 32768.0f);
    pMainGainQ15 = 32768 - (int32_t)(sl * 0.35f * 32768.0f);

    pSwingQ8     = (int32_t)(clampF(paramSwing, 0.0f, 1.0f) * 85.0f);

    pWtPosQ16    = (int32_t)(clampF(paramWtPos, 0.0f, 1.0f) * 65535.0f);
    pWtLfoQ15    = (int32_t)(clampF(paramWtLfo, 0.0f, 1.0f) * 32768.0f);

    // matriz de modulação -> inteiros Q15
    bool mmAny = false, mmPit = false;
    for (int i = 0; i < 16; i++) {
        float a = clampF(mmAmt[i], -1.0f, 1.0f);
        pMmQ15[i] = (int32_t)(a * 32768.0f);
        if (fabsf(a) > 0.004f) { mmAny = true; if ((i >> 2) == 1) mmPit = true; }
    }
    pMmOn = mmAny;
    pPitchModOn = mmPit;

    float gm = (paramGlideMs < 1.0f) ? 1.0f : paramGlideMs;
    int gs = (int)(log2f(gm * 32.0f) + 0.5f);
    if (gs < 5) gs = 5;
    if (gs > 14) gs = 14;
    pGlideShift  = gs;

    pPitchDecInc = envIncFor(paramPitchDecMs * 0.001f);
    pPitchOn     = (paramPitchAmt > 0.01f);

    // OSC2
    float o2l = clampF(paramO2Lvl, 0.0f, 1.0f);
    float semi = clampF(paramO2Semi, -24.0f, 24.0f);
    float cents = clampF(paramO2Det, -100.0f, 100.0f);
    pO2MulQ8    = (int32_t)(exp2f((semi + cents / 100.0f) / 12.0f) * 256.0f + 0.5f);
    pO2MainQ15  = 32768 - (int32_t)(o2l * 0.30f * 32768.0f);
    pO2GainQ15  = (int32_t)(o2l * 0.75f * 32768.0f);
    pO2Sync     = o2Sync;
    pO2On       = (o2l > 0.01f);

    // UNISON: 1 / 2 / 3 / 5 cópias; deslocamentos relativos (Q8) de -1..+1
    static const int     UNI_N[4]    = {1, 2, 3, 5};
    static const int32_t UNI_GAIN[4] = {32768, 23170, 18918, 14654};      // ~1/raiz(N)
    static const int16_t UNI_OFF[4][5] = {{0, 0, 0, 0, 0}, {-256, 256, 0, 0, 0}, {-256, 0, 256, 0, 0}, {-256, -128, 0, 128, 256}};
    int us = uniSel & 3;
    pUniN = UNI_N[us];
    pUniGainQ15 = UNI_GAIN[us];
    float spreadFrac = clampF(paramUniDet, 0.0f, 1.0f) * 0.025f;         // até ~ +-43 cents
    for (int k = 0; k < 5; k++) pUniSpreadQ16[k] = (int32_t)(spreadFrac * 65536.0f * (float)UNI_OFF[us][k] / 256.0f);

    // FM
    float fa = clampF(paramFmAmt, 0.0f, 1.0f);
    pFmIdxQ12   = (int32_t)(fa * fa * 2.0f * 4096.0f);                  // 0..2 ciclos
    pFmRatioQ8  = (int32_t)(clampF(paramFmRatio, 0.25f, 12.0f) * 256.0f + 0.5f);
    pFmEnvQ15   = (int32_t)(clampF(paramFmEnv, 0.0f, 1.0f) * 32768.0f);
    pFmFbQ12    = (int32_t)(clampF(paramFmFb, 0.0f, 1.0f) * 1200.0f);
    pFmDecInc   = envIncFor(clampF(paramFmDecMs, 5.0f, 2000.0f) * 0.001f);
    pFmOn       = (pFmIdxQ12 > 4);

    // tabela do pitch envelope: só recalcula quando a quantidade muda (troca atômica de tabela)
    static float lastPitchAmt = -1.0f;
    if (fabsf(paramPitchAmt - lastPitchAmt) > 0.001f) {
        lastPitchAmt = paramPitchAmt;
        uint8_t nxt = pitchTblSel ^ 1;
        float oct = clampF(paramPitchAmt, 0.0f, 1.0f) * 3.0f;
        for (int i = 0; i < 129; i++) {
            pitchMulTbl[nxt][i] = (uint32_t)(exp2f(oct * (float)i * (1.0f / 128.0f)) * 65536.0f);
        }
        pitchTblSel = nxt;
    }
}

// ============================================================================
// ENCODER E TOQUE
// ============================================================================
// ENCODER (lido por interrupção; as leituras no loop1 perdiam passos durante
// os redesenhos da tela). Girar acelera: devagar = passos finos, rápido = grandes.
//   girar                 -> CUTOFF
//   segurar + girar       -> RESSONÂNCIA
//   clique curto          -> PLAY / STOP do sequenciador
//   segurar ~0,8 s parado -> PÂNICO (solta todas as notas e para o sequenciador)
const uint16_t BTN_DEBOUNCE_MS = 25;
const uint16_t ENC_QUIET_MS    = 250;     // botão só vale se o eixo estava parado antes de apertar
const uint16_t BTN_LONG_MS     = 800;
const bool  ENC_INVERT     = false;   // true se o sentido estiver trocado
const float ENC_STEP_FINE  = 0.005f;  // 0,5% por clique (giro lento)
const float ENC_STEP_MID   = 0.012f;
const float ENC_STEP_FAST  = 0.025f;  // giro rápido
const uint8_t ENC_FAST_MS  = 25;      // intervalo entre cliques abaixo disso = rápido
const uint8_t ENC_MID_MS   = 60;

#define R_START      0x0
#define R_CW_FINAL   0x1
#define R_CW_BEGIN   0x2
#define R_CW_NEXT    0x3
#define R_CCW_BEGIN  0x4
#define R_CCW_FINAL  0x5
#define R_CCW_NEXT   0x6
const uint8_t rotaryTable[7][4] = {
    {R_START,    R_CW_BEGIN,  R_CCW_BEGIN, R_START},
    {R_CW_NEXT,  R_START,     R_CW_FINAL,  R_START | 0x10},
    {R_CW_NEXT,  R_CW_BEGIN,  R_START,     R_START},
    {R_CW_NEXT,  R_CW_BEGIN,  R_CW_FINAL,  R_START},
    {R_CCW_NEXT, R_START,     R_CCW_BEGIN, R_START},
    {R_CCW_NEXT, R_CCW_FINAL, R_START,     R_START | 0x20},
    {R_CCW_NEXT, R_CCW_FINAL, R_CCW_BEGIN, R_START},
};
uint8_t rotaryState = R_START;

static int8_t __not_in_flash_func(readRotaryStep)() {
    int pinstate = (digitalRead(ENC_CLK) << 1) | digitalRead(ENC_DT);
    rotaryState = rotaryTable[rotaryState & 0x0F][pinstate];
    uint8_t result = rotaryState & 0x30;
    rotaryState &= 0x0F;
    if (result == 0x10) return +1;
    if (result == 0x20) return -1;
    return 0;
}

// interrupção nos dois pinos (CHANGE): só acumula os cliques; o loop1 aplica
static volatile int16_t encSteps = 0;
static volatile uint32_t encEdgeMs = 0;     // último movimento em CLK/DT (mesmo sem completar um clique)
void __not_in_flash_func(encoderISR)() {
    encEdgeMs = millis();
    int8_t d = readRotaryStep();
    if (d) encSteps += d;
}

void encoderBegin() {
    pinMode(ENC_CLK, INPUT_PULLUP);
    pinMode(ENC_DT, INPUT_PULLUP);
    pinMode(ENC_SW, INPUT_PULLUP);       // botão entre GP2 e GND
    attachInterrupt(digitalPinToInterrupt(ENC_CLK), encoderISR, CHANGE);
    attachInterrupt(digitalPinToInterrupt(ENC_DT),  encoderISR, CHANGE);
}

// estado do botão (com debounce)
static bool btnDown = false, btnRaw = false;
static unsigned long btnRawSince = 0, btnPressedAt = 0;
static bool btnTurned = false;           // girou enquanto segurava -> não é clique
static bool btnLongDone = false;
static bool btnQuiet = false;            // o aperto começou com o eixo parado (aperto de verdade)
static int32_t encStepTotal = 0;         // teste do encoder (MOD > VOICE/GLIDE)
static uint16_t encSwNoise = 0;          // apertos ignorados porque vieram durante o giro

// Encoders baratos (e fios longos ou mal presos) fazem o pino do botão "piscar" enquanto o eixo
// gira. Um aperto que começa durante o giro é ignorado: não dá PLAY/STOP nem vira ressonância.
static void encoderButton(unsigned long now) {
    bool raw = (digitalRead(ENC_SW) == LOW);
    if (raw != btnRaw) { btnRaw = raw; btnRawSince = now; }
    if (raw != btnDown && now - btnRawSince >= BTN_DEBOUNCE_MS) {
        btnDown = raw;
        if (btnDown) {                   // apertou
            btnPressedAt = now;
            btnTurned = false;
            btnLongDone = false;
            btnQuiet = (now - encEdgeMs >= ENC_QUIET_MS);
            if (!btnQuiet) encSwNoise++;
        } else if (btnQuiet && !btnTurned && !btnLongDone &&
                   now - encEdgeMs >= 60) {          // soltou: clique curto (e o eixo não mexeu)
            seqCmd = seqRunning ? 2 : 1;
            snprintf(lastMidiMsg, sizeof(lastMidiMsg), seqRunning ? "SEQ STOP" : "SEQ PLAY");
        }
    }
    // segurou parado: pânico (uma vez por toque)
    if (btnDown && btnQuiet && !btnTurned && !btnLongDone && now - btnPressedAt >= BTN_LONG_MS) {
        btnLongDone = true;
        if (seqRunning) seqCmd = 2;
        monoResetReq = true;             // o core de áudio solta todas as vozes
        snprintf(lastMidiMsg, sizeof(lastMidiMsg), "PANIC");
    }
}

void readEncoder() {
    static unsigned long lastStepMs = 0;
    unsigned long now = millis();
    encoderButton(now);

    noInterrupts();
    int16_t n = encSteps;
    encSteps = 0;
    interrupts();
    if (n == 0) return;
    if (ENC_INVERT) n = -n;

    unsigned long perClick = (now - lastStepMs) / (unsigned long)abs(n);   // tempo médio por clique
    lastStepMs = now;
    float step = (perClick < ENC_FAST_MS) ? ENC_STEP_FAST : ((perClick < ENC_MID_MS) ? ENC_STEP_MID : ENC_STEP_FINE);

    encStepTotal += n;
    if (btnDown) btnTurned = true;
    if (btnDown && btnQuiet) {           // segurando de verdade: ressonância
        paramReso = constrain(paramReso + (float)n * step, 0.0f, 1.0f);
    } else {
        paramCutoff = constrain(paramCutoff + (float)n * step, 0.05f, 1.0f);
    }
    syncKnobsFromParams();               // mantém os knobs MIDI coerentes
}

// ---- calibração do touch: leitura bruta nas bordas da tela (x=0/320, y=0/240) ----
// Sem calibração gravada vale o padrão TS_MIN/TS_MAX. Grava em CAL_ADDR.
const int     CAL_ADDR  = 3700;
const uint8_t CAL_MAGIC = 0xCA;
struct TouchCal { int16_t x0, x1, y0, y1; };
TouchCal touchCal = {TS_MAXX, TS_MINX, TS_MAXY, TS_MINY};

void touchCalLoad() {
    if (EEPROM.read(CAL_ADDR) != CAL_MAGIC) return;
    TouchCal c;
    EEPROM.get(CAL_ADDR + 1, c);
    // descarta dados absurdos (ex.: EEPROM corrompida): exige faixa mínima em cada eixo
    if (abs(c.x1 - c.x0) < 1000 || abs(c.y1 - c.y0) < 1000) return;
    touchCal = c;
}

void touchCalSave() {
    EEPROM.write(CAL_ADDR, CAL_MAGIC);
    EEPROM.put(CAL_ADDR + 1, touchCal);
    EEPROM.commit();
}

bool getTouch(int &sx, int &sy) {
    if (!ts.touched()) return false;
    TS_Point p = ts.getPoint();
    sx = map(p.x, touchCal.x0, touchCal.x1, 0, 320);
    sy = map(p.y, touchCal.y0, touchCal.y1, 0, 240);
    sx = constrain(sx, 0, 319);
    sy = constrain(sy, 0, 239);
    return true;
}

// ============================================================================
// GRÁFICOS E INTERFACE
// ============================================================================
const char* waveShortName(Waveform w) {
    switch (w) {
        case WAVE_SAW: return "SAW";    case WAVE_SQUARE:   return "SQR";
        case WAVE_TRIANGLE: return "TRI"; case WAVE_SINE:   return "SIN";
        case WAVE_PULSE: return "PLS";  case WAVE_SUPERSAW: return "SSW";
        case WAVE_NOISE: return "NSE";  case WAVE_TABLE:    return "WT";
        default: return "?";
    }
}
float waveShapeFor(Waveform w, float t) {
    switch (w) {
        case WAVE_TABLE: {           // ícone mostra o quadro mais próximo da posição base
            int f = constrain((int)(paramWtPos * 7.0f + 0.5f), 0, 7);
            return (float)wtData[0][wtBank & 3][f][(int)(t * 256.0f) & 255] / 32768.0f;
        }
        case WAVE_SAW:      return t * 2.0f - 1.0f;
        case WAVE_SQUARE:   return (t >= 0.5f) ? 1.0f : -1.0f;
        case WAVE_PULSE:    return (t >= 0.3f) ? 1.0f : -1.0f;
        case WAVE_TRIANGLE: { float saw = t * 2.0f - 1.0f; return fabsf(saw) * 2.0f - 1.0f; }
        case WAVE_SUPERSAW: { float saw = t * 2.0f - 1.0f; return saw * 0.9f; }
        case WAVE_NOISE:    return (float)random(-100, 100) / 100.0f;
        case WAVE_SINE:
        default: return sinf(2.0f * (float)M_PI * t);
    }
}
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
void loop() {
    static uint32_t cpuBusyUs = 0, cpuSamples = 0;
    static unsigned long cpuWinStart = 0;

    for (int i = 0; i < 16 && MIDI.read(); i++) { }

    if (monoResetReq) {
        monoResetReq = false;
        synthAllNotesOff();
        monoCount = 0;
        monoVoiceNote = -1;
    }

    uint32_t t0 = micros();
    int n = audioProcess();
    if (n > 0) {
        cpuBusyUs += (uint32_t)(micros() - t0);
        cpuSamples += (uint32_t)n;
    }

    unsigned long now = millis();
    if (now - cpuWinStart >= 500) {
        if (cpuSamples > 0) {
            float perSample = (float)cpuBusyUs / (float)cpuSamples;
            int p = (int)(perSample * 3.2f + 0.5f);
            if (p < 0) p = 0;
            if (p > 100) p = 100;
            cpuPct = (uint8_t)p;
        }
        cpuBusyUs = 0;
        cpuSamples = 0;
        cpuWinStart = now;
    }
}
