joaobritooo/tobri-synth-rp2040/(commit log)

2026-10-31 Tobri Synth RP2040: firmware v6, caixa Eurorack, manual e esquema de ligação
    Sintetizador de 4 vozes no Raspberry Pi Pico com tela touch ILI9341,
    DAC I2S UDA1334A, encoder e USB MIDI. Inclui modelos OpenSCAD/STL da
    caixa 20 HP, manual ilustrado, esquema de ligação e o emulador da tela.
    [tobri_eurorack.scad, tobri_knob.stl, tobri_painel_knob.scad, tobri_panel.stl, tobri_shelf.stl]
2026-11-01 Firmware v7: menu de páginas com nomes e abas reorganizadas
    - Tocar na aba que já está aberta abre um menu com o nome de cada
    página (também na aba FX); swipe continua funcionando.
    - ENV reúne os três envelopes: AMP, FILTER ENV (com gráfico) e PITCH.
    - FLT: FILTER (cutoff, reso, drive) e MODE / FOLD.
    - MOD: LFO, MATRIX e VOICE/GLIDE.
    - Manual e imagens do README atualizados.
2026-11-01 Firmware v8: RANDOM inteligente e tela de abertura estilo Matrix
    - PRE p1 ganha RANDOM: sorteia o tipo de som (BASS, LEAD, PAD, PLUCK,
    KEYS) e depois cada parâmetro dentro de faixas musicais para o tipo.
    UNDO volta ao som anterior e REDO refaz.
    - Abertura de ~3 s com números caindo e "TOBRI SYNTH / desenvolvido
    por @t.obr.i 2026".
    - Manual, emulador e README atualizados.
2026-11-01 Firmware v9: abertura com as cores do menu e transição para a interface
    - A abertura usa a mesma paleta da interface (COL_BG/COL_TEXT e cinzas),
    então fica igual ao menu também em painéis IPS que invertem as cores.
    - Transição: linha de varredura apaga a abertura e as abas descem uma a
    uma antes da primeira página aparecer.
2026-11-01 Firmware v10: girar o encoder não dispara mais PLAY/STOP
    O pino do botão (GP4) pode "piscar" enquanto o eixo gira, por ruído do
    contato ou da fiação, e cada piscada virava um clique. Agora um aperto
    que começa até 250 ms depois de qualquer movimento em CLK/DT é ignorado:
    não dá PLAY/STOP, não vira ressonância e não aciona o pânico. O debounce
    subiu para 25 ms.
    MOD > VOICE/GLIDE ganhou um teste do encoder ao vivo (CLK, DT, SW,
    passos e apertos ignorados) para conferir a fiação.
2026-11-01 Firmware v11: presets de fábrica de minimal / deep tech
    Os 8 presets viram ROLLER, DUB CHORD, HYPNO PLCK, RUMBLE, BLIP, DEEP PAD,
    ACID TOOL e METAL PERC. Cada um tem extras de fábrica (LFO, OSC2, FM,
    wavetable, chorus, bitcrusher, accent) e um groove em Sol menor no
    padrão A, com BPM de 120 a 126 e swing. Níveis conferidos no emulador
    sem CLIP. Manual com a seção dos presets.
2026-11-01 Grooves de fábrica sem probabilidade: todas as notas tocam
    Alguns passos dos presets de minimal / deep tech estavam com PROB de
    75/50/25 %, então às vezes não tocavam e isso parecia defeito. Agora
    todo passo com nota toca sempre; quem quiser variação liga PROB no passo.
    Conferido no emulador: 4 compassos de cada preset, nenhuma nota perdida.
2026-11-09 Firmware v12: encoder com giro em GP4/GP3 e botão em GP2
    Na placa montada o fio do CLK está no GP4 e o do botão no GP2. Em vez de
    trocar a solda, o firmware passa a usar essa ligação (giro testado no
    emulador: cutoff, clique = PLAY/STOP, segurar + girar = ressonância,
    segurar parado = pânico). Esquema de ligação, pinagem, manual e README
    atualizados.
